dfrister/Practicum2014/Presentation/Images/display_bottom.jpg

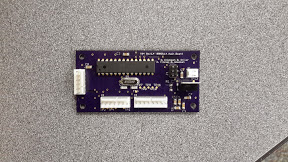
Presentation/Images/display_bottom.jpg
