dfrister/Practicum2014/Presentation/Images/display_top.jpg

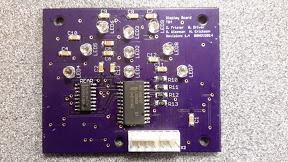
Presentation/Images/display_top.jpg
