dfrister/Practicum2014/Code/README.txt

FinalCode:
This version of the code is completely functional and uploaded to all our boards.
