dfrister/Practicum2014/Enclosures/Sensor Enclosure.pdf

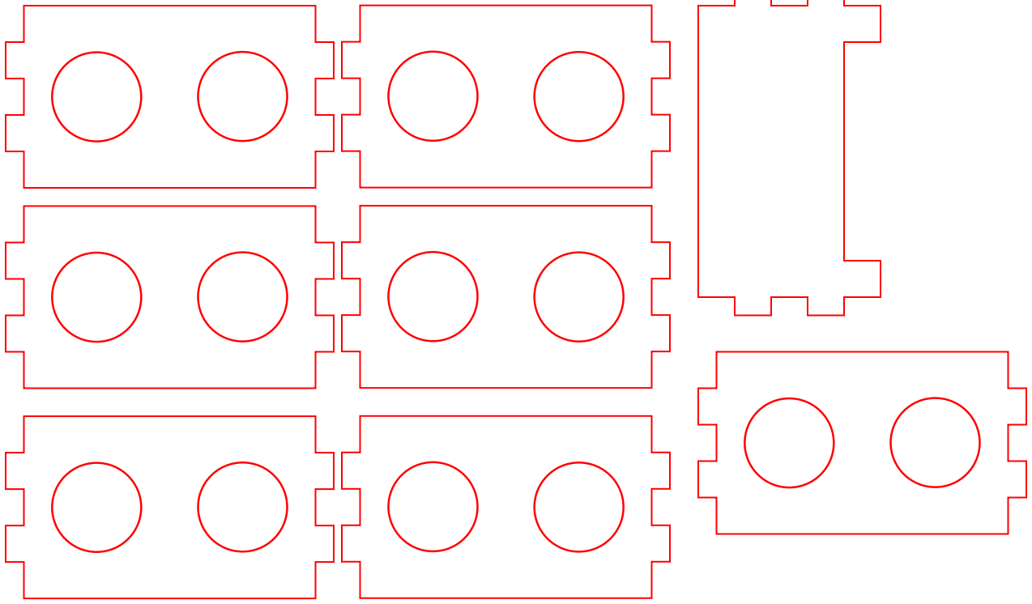
[picture p14: figure]
