dfrister/Practicum2014/UML/InteractiveView.pdf

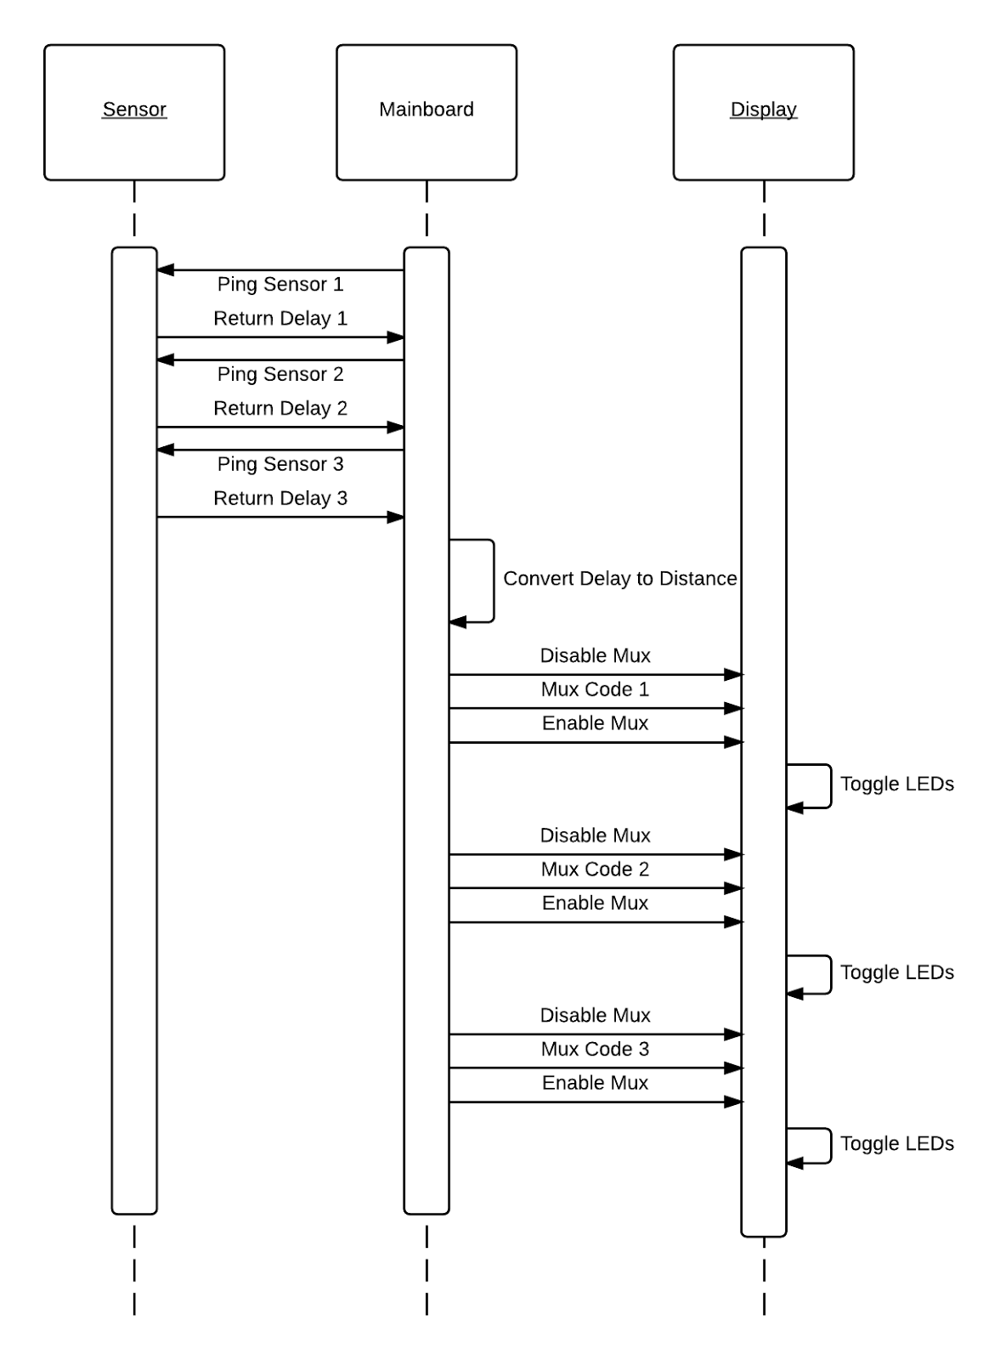
[picture p15: figure]

Interaction View
