dfrister/Practicum2014/UML/MainBoardStateDiagram.pdf

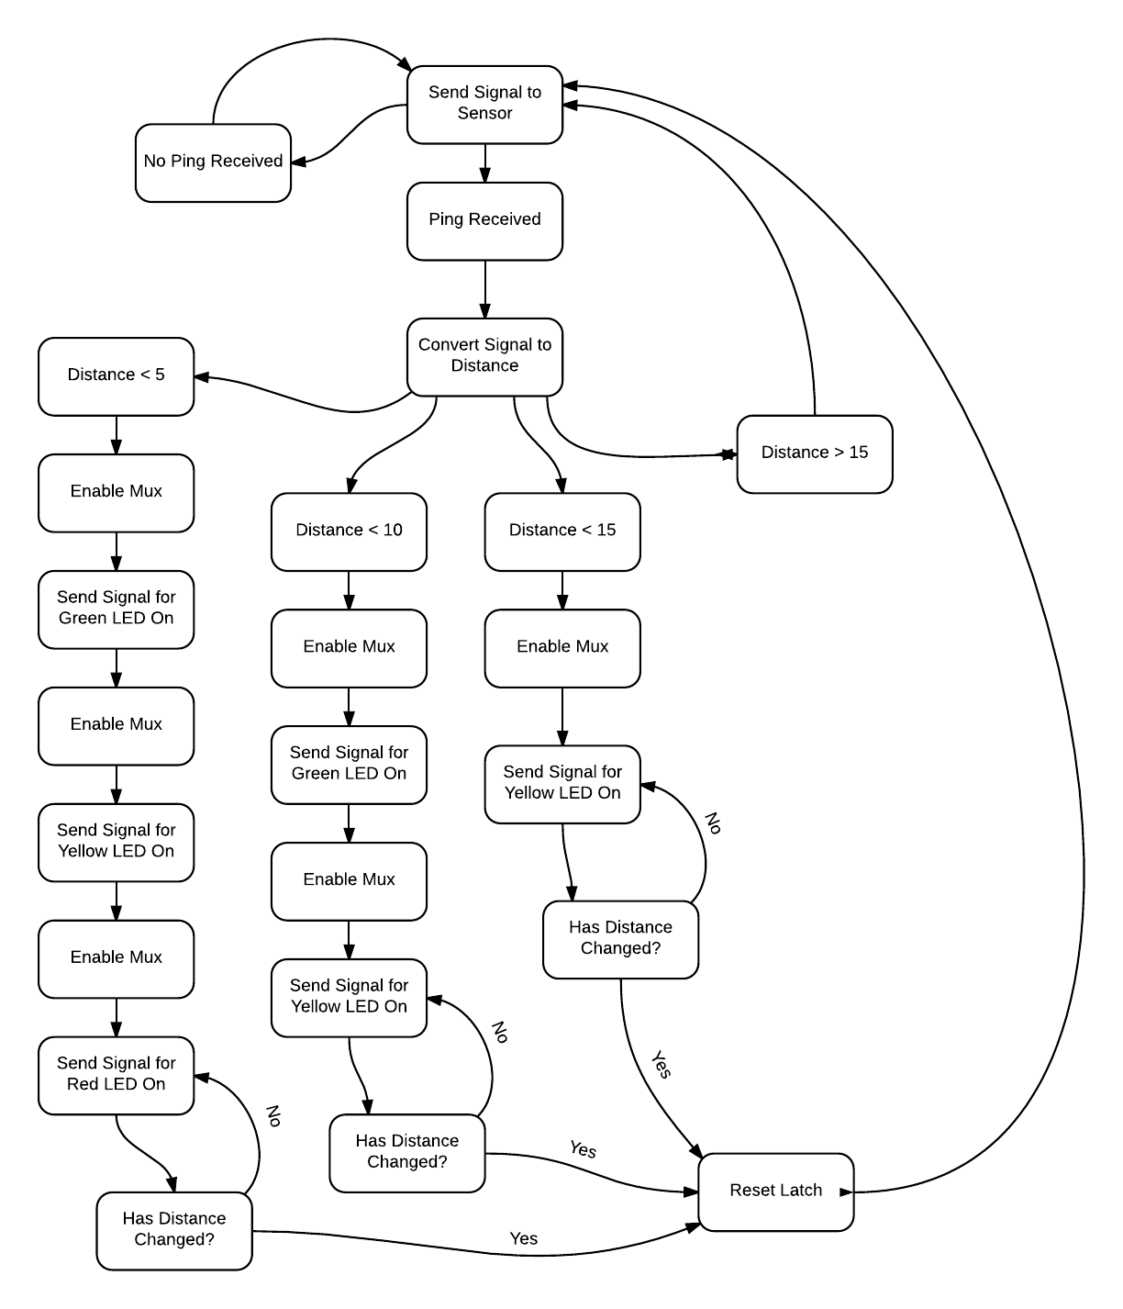
[picture p16: figure]
