dfrister/Practicum2014/Meeting Notes/20OCT2014Notes.pdf

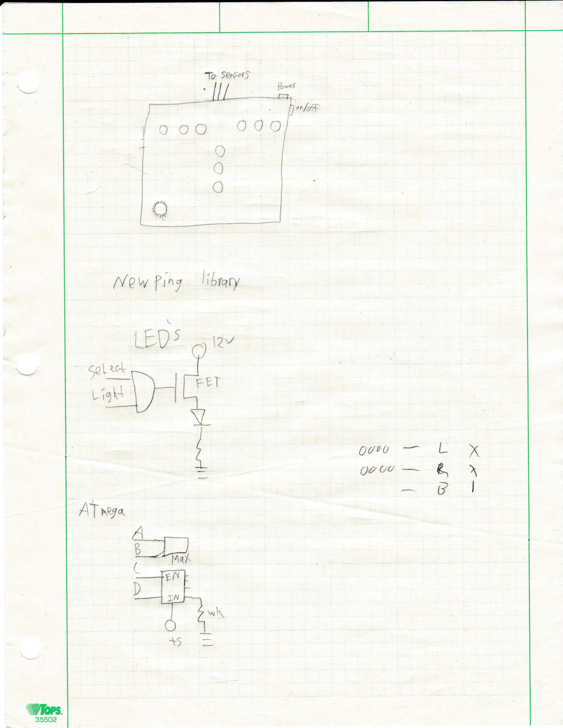
[picture p17: page 1]

- | a... | !

?rt0 .-

cl6 80
-T

### ,.LXq\

#l

{
:-

## I r&d 6rT

## :!.- i i ' I'

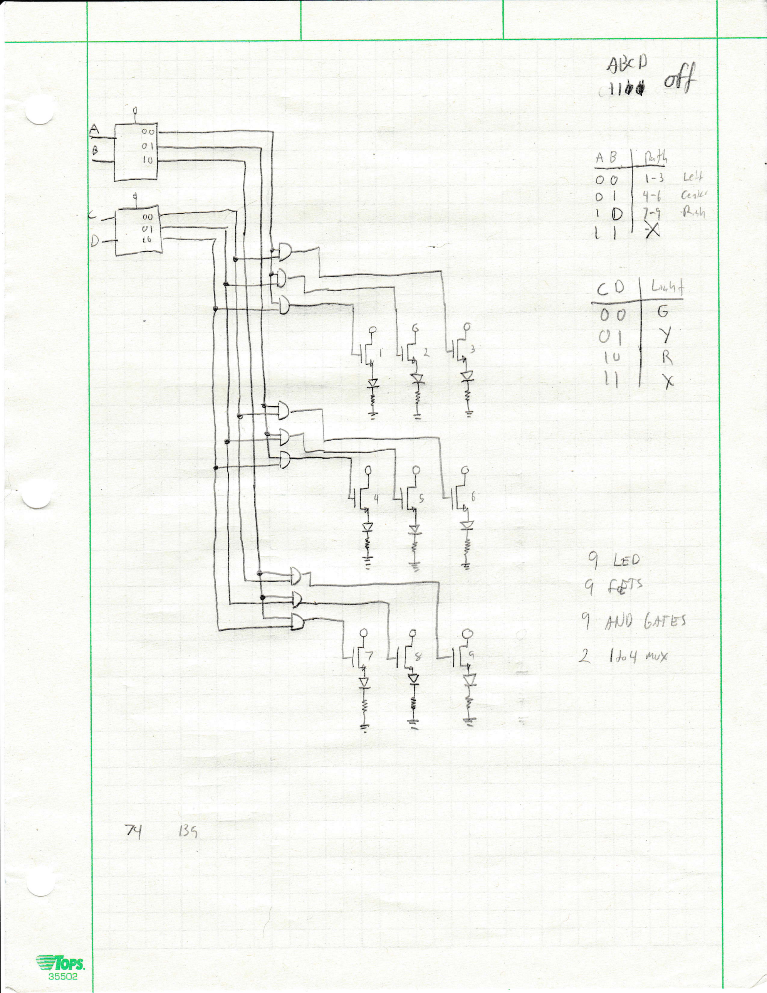
[picture p18: page 2]

a t- i

## -lr-I

# ill

t

lY

# ii ll f

x

4B{ D rr

ii
--,i*"*- I

ijU ii
.I ...ii--l I {i) i

1 Leo

## q F$t

### 1 *r;i 6*re'l

2 lS.rl xuq rl

ai I I q

lsL' vTJt

"_

Yi

\i
t.'4I
\:7

.:

7rl t3\

=roHs. 35502
