dfrister/Practicum2014/Project Ideas and Proposal/Decision Matrix.xlsx

Criteria: |  |  | Projects:
Complexity | A |  | IR Power | 1
Match to Skills | B |  | Shift Light | 2
Feasibility | C |  | Kid Leash | 3
Personal Interest | D |  | Prox Sensor | 4
Usefulness | E
Weighting Chart
 | A | B | C | D | E | Geometric Mean | Normalized Weights
A | 1.00 | 3.00 | 1.00 | 0.33 | 5 | 1.37 | 0.24
B | 0.33 | 1 | 0.33 | 0.33 | 3 | 0.64 | 0.11
C | 1 | 3 | 1 | .33 | 3 | 1.2 | 0.21
D | 3 | 3 | 3 | 1 | 7 | 2.2 | 0.38
E | .2 | .33 | .33 | .14 | 1 | 0.31 | 0.05
Comparison: Complexity | 1 | 2 | 3 | 4 | Geometric Mean | Normalized Weights |  | Scores
1 | 1 | 3 | 5 | 3 | 2.942830956 | 0.5209547068 |  | Selection Criteria | Weights | Alternatives
2 | 0.33 | 1 | 2 | 1 | 1.071873374 | 0.1897484046 |  |  |  | 1 | 2 | 3 | 4
3 | 0.2 | 0.5 | 1 | 0.5 | 0.5623413252 | 0.09954848393 |  | A (Complexity) | 0.24 | 0.5209547068 | 0.1897484046 | 0.09954848393 | 0.1897484046
4 | 0.33 | 1 | 2 | 1 | 1.071873374 | 0.1897484046 |  | B (Skills) | 0.11 | 0.3520015706 | 0.1760007853 | 0.1760007853 | 0.2959968589
 |  |  |  |  |  |  |  | C (Feasibility) | 0.21 | 0.3539527705 | 0.1019209567 | 0.1901735022 | 0.3539527705
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
