dfrister/Practicum2014/Presentation/Images/Mainboard.jpg

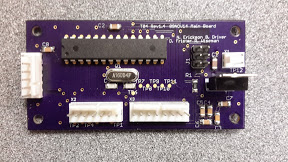
Presentation/Images/Mainboard.jpg
