dfrister/Practicum2014/Wiki Images/Concept.jpg

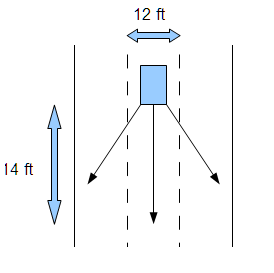
Wiki Images/Concept.jpg
