dfrister/Practicum2014/Components/Components and Pricing Sheet.xlsx

Manufacturer | Part # | Component | Supplier | Price | Qty/Person | Total Qty | Total Price |  | Model |  | Prototype Order 10/26
Lite-On | LTL1CHKGKNN | Green LED | Mouser | $0.11 | 3 | 12 | $1.28 | 3mm | Final | Final Build | Manufacturer | Part # | Component | Supplier | Price | Qty | Total
Lite-On | LTL1CHKEKNN | Red LED | Mouser | $0.09 | 3 | 12 | $1.08 | 3mm | Final | Prototype | Lite-On | LTL1CHKGKNN | Green LED | Mouser | $0.11 | 12 | $1.28
Lite-On | LTL1CHKSKNN | Yellow LED | Mouser | $0.10 | 3 | 12 | $1.22 | 3mm | Final | Ordered | Lite-On | LTL1CHKEKNN | Red LED | Mouser | $0.09 | 12 | $1.08
Fairchild | 2n7002DW | Dual N-channel FET | Mouser | $0.28 | 5 | 20 | $5.52 | smt | Final | Substituted | Lite-On | LTL1CHKSKNN | Yellow LED | Mouser | $0.10 | 12 | $1.22
Fairchild | 2n7000 | N-Channel FET | Mouser | $0.24 | 10 | 10 | $2.40 | Thru-Hole | Prototype |  | Fairchild | 2n7000 | N-Channel FET | Mouser | $0.24 | 10 | $2.40
ON-Semiconductor | MC14514BDWR2G | 4-16 demux | Mouser | $1.61 | 1 | 4 | $6.44 | smt | n/a |  | NXP Semiconductor | HEF4067BPN | 4-16 demux | Mouser | $5.43 | 1 | $5.43
ON-Semiconductor | CD4043BE | Quad SR latch | Mouser | $0.60 | 3 | 4 | $2.40 | Thru-Hole | Prototype |  | ON-Semiconductor | CD4043BE | Quad SR latch | Mouser | $0.60 | 4 | $2.40
ON-Semiconductor | CD4043BDWR | Quad SR latch | Mouser | $0.67 | 3 | 12 | $8.04 | SMT | final
NXP Semiconductor | HEF4067BPN | 4-16 demux | Mouser | $5.43 | 1 | 1 | $5.43 | Thru-Hole | Prototype
NXP Semiconductor | HEF4067BT | 4-16 demux | Mouser | $2.38 | 1 | 4 | $9.52 | SMT | final |  |  |  |  |  |  | Shipping | 6.99
 |  |  |  |  |  | 0 | $0.00
 |  |  |  |  |  | 0 | $0.00
 |  |  |  |  |  | 0 | $0.00
 |  |  |  |  |  | 0 | $0.00 |  |  |  |  |  |  |  |  |  | $20.81
 |  |  |  |  |  | 0 | $0.00
 |  |  |  |  |  | 0 | $0.00
