dfrister/Practicum2014/Test Plan/Test_Case_4.5.1_integration.xlsx

Test Writer: Daniel Frister
Test Case Name: |  | Main Board to Display Test #1 |  |  | Test ID: | MPS-Integration-01
Description: |  | Checks that binary inputs to the display board produce the correct corresponding outputs on the demultiplexer. |  |  | Type: | Black Box
Tester Information:
Name of Tester: |  |  |  |  | Date:
Harware Ver: |  | Main Board V1.0, Display V1.0 |  |  | Time:
Setup: |  | Display board should have 5V and seven pin cable to main board attached. Main board should be powered, have seven pin cable to display board connected, and be loaded with a program to output as a four bit digital up counter with output enable at clock rate 0.5 Hz. Oscilloscope should be connected at channels A0-A3 on main board molex connector.
Step | Action | Expected Result | Pass | Fail | Comments
1 | Observe binary 0 | Right Display Green LED lights
2 | Observe binary 1 | Right Display Yellow LED lights
3 | Observe binary 2 | Right Display Red LED lights
4 | Observe binary 3 | All Right Display LEDs turn off
5 | Observe binary 4 | Rear Display Green LED lights
6 | Observe binary 5 | Rear Display Yellow LED lights
7 | Observe binary 6 | Rear Display Red LED lights
8 | Observe binary 7 | All Rear Display LEDs turn off
9 | Observe binary 8 | Left Display Green LED lights
10 | Observe binary 9 | Left Display Yellow LED lights
11 | Observe binary 10 | Left Display Red LED lights
12 | Observe binary 11 | All Left Display LEDs turn off
13 | Observe binary 12 | No display changes
14 | Observe binary 13 | No display changes
15 | Observe binary 14 | No display changes
16 | Observe binary 15 | No display changes
Overall test result
