dfrister/Practicum2014/Test Plan/Test_Case_4.5.3_system.xlsx

Test Writer: Branden Driver
Test Case Name: |  | Entire System Test #1 |  |  | Test ID: | MPS-System-01
Description: |  | Checks that all connections are functioning properly and that the code loaded onto the microcontroller is set for the correct distances. |  |  | Type: | Black Box
Tester Information:
Name of Tester: |  |  |  |  | Date:
Harware Ver: |  | Display V1.0, Main Board V1.5, Sensor V1.0 |  |  | Time:
Setup: |  | Both Sensor Board and Display Board will be wire-connected to the Main Board. Main Board will be connected to power supply of at least 6V and at most 12V. Set Sensor Board on edge of table with Left Sensor facing straight out. Using tape measure and masking tape, mark off distances of 5, 10, and 15 feet. Have a flat, solid, light-weight surface (such as a textbook) to place in front of sensor at different distances.
Step | Action | Expected Result | Pass | Fail | Comments
1 | Place suface at distance of 15' | Left Green LED lights up
2 | Place suface at distance of 10' | Left Green and Yellow LEDs light up
3 | Place suface at distance of 5' | Left Green, Yellow, and Red LEDs light up
4 | Rotate Sensor Board so Rear Sensor faces out | Rear Sensor ready to be tested
5 | Place suface at distance of 15' | Rear Green LED lights up
6 | Place suface at distance of 10' | Rear Green and Yellow LEDS light up
7 | Place suface at distance of 5' | Rear Green, Yellow, and Red LEDs light up
8 | Rotate Sensor Board so Right Sensor faces out | Right Sensor ready to be tested
9 | Place suface at distance of 15' | Right Green LED lights up
10 | Place suface at distance of 10' | Right Green and Yellow LEDs light up
11 | Place suface at distance of 5' | Right Green, Yellow, and Red LEDs light up
Overall test result
