dfrister/Practicum2014/Test Plan/TestCaseMainboardHelloWorld.xls

Test Writer: Noah L. Engineer
Test Case Name: |  | Motorcycle Proximity Sensor Mainboard Path Test #1 |  |  |  | Test ID #: | MPS-Main Path-01
Description: |  | Upload “Hello World” to microcontroller |  |  |  | Type: | Black Box
Tester Information
Name of Tester: |  |  |  |  |  | Date:
Hardware Ver: |  | Mainboard Rev 1.5 |  |  |  | Time:
Setup: |  | The mainboard should be completely assembled and should be connected to the 5V power supply. The input voltage to the power supply should be anywhere from 6V to 12V. The USB to serial programming cable should be connected to the 6 pin serial programming header on the mainboard. A standard 5mm LED should be connected to one of the display board header pins and a 330 Ohm resistor.
Step | Action | Expected Result | Pass | Fail | N/A | Comments
1 | Turn on input voltage | Mainboard should be powered
2 | Write program in Arduino IDE | A source code file that compiles without errors with the purpose of blinking an LED
3 | Upload program to mainboard | The program should
4 | Wait | The LED should blink
Overall Test Result:
