dfrister/Practicum2014/Presentation/Images/T04_Display.sch.pdf

1 | 2 | 3 | 4 | 5 | 6 | 7 | 8 | 9

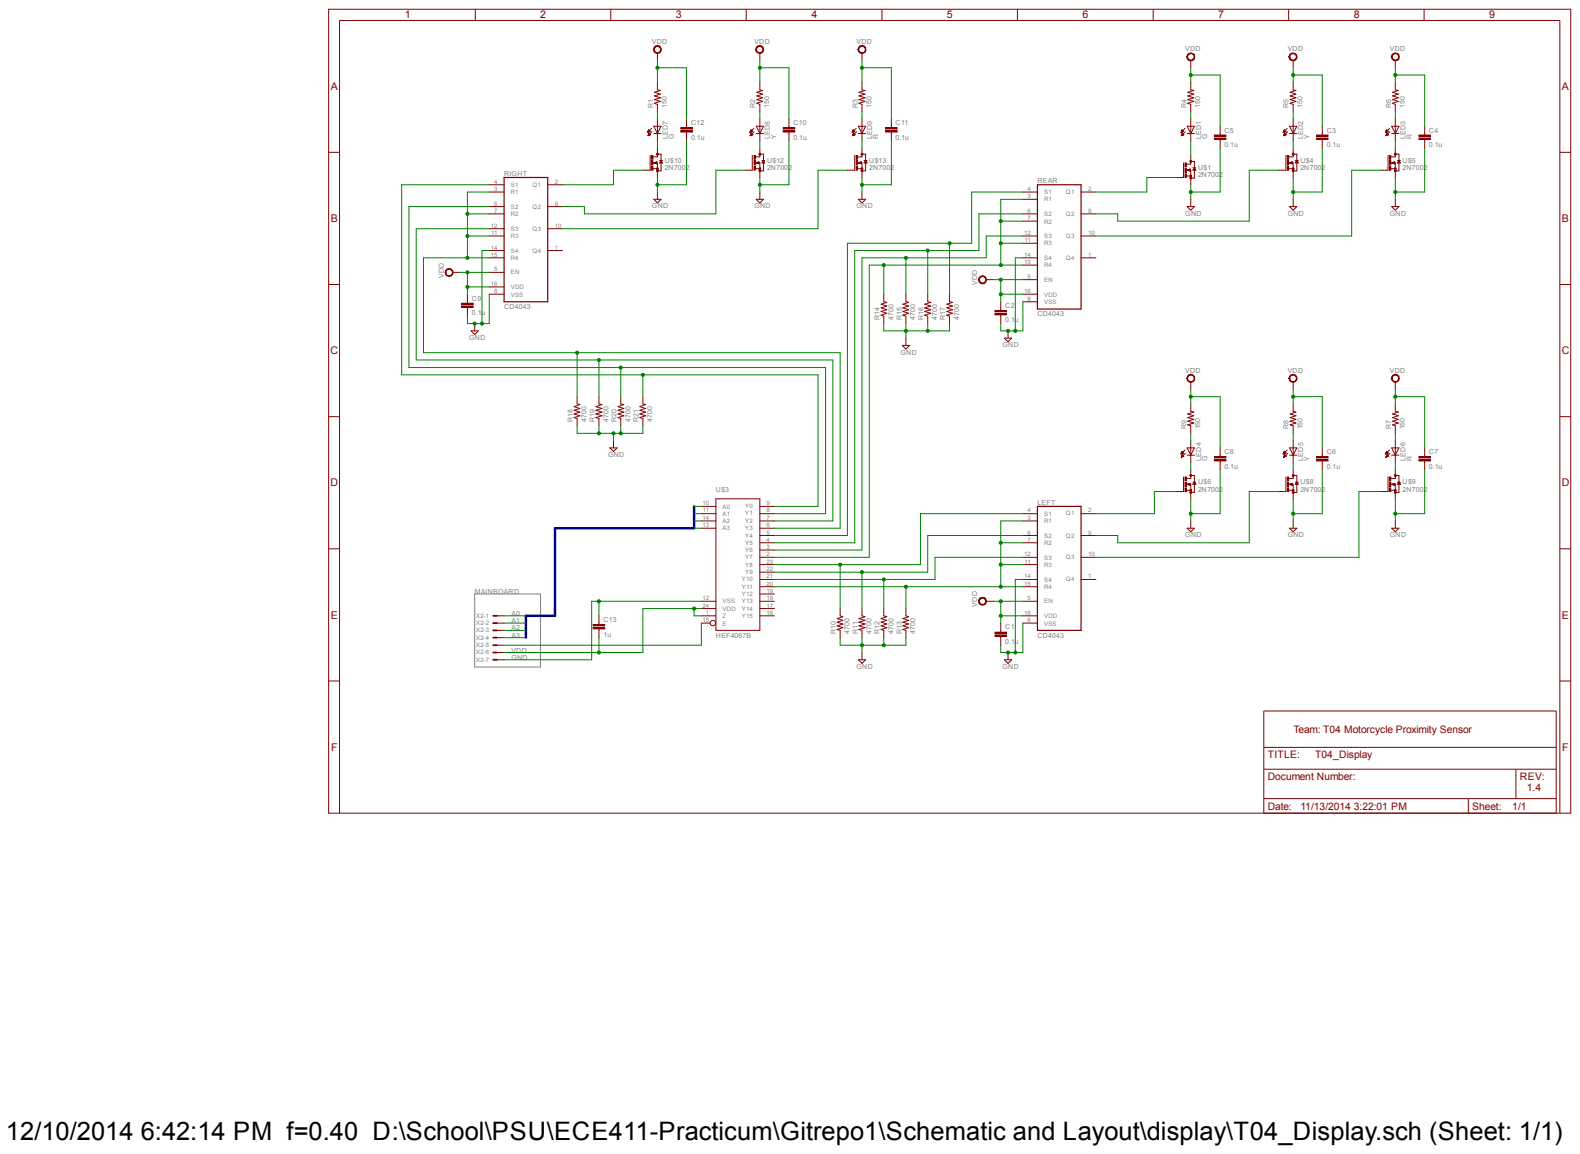
[picture p21: page 1]

R3 11 S3 12
S4 14 | | R3 11 S3 12

Team: T04 Motorcycle Proximity Sensor

Document Number: | REV: 1.4

Date: 11/13/2014 3:22:01 PM | Sheet: 1/1

12/10/2014 6:42:14 PM f=0.40 D:\School\PSU\ECE411-Practicum\Gitrepo1\Schematic and Layout\display\T04_Display.sch (Sheet: 1/1)
