dfrister/Practicum2014/Presentation/Images/T04_Main_Board.sch.pdf

A

A

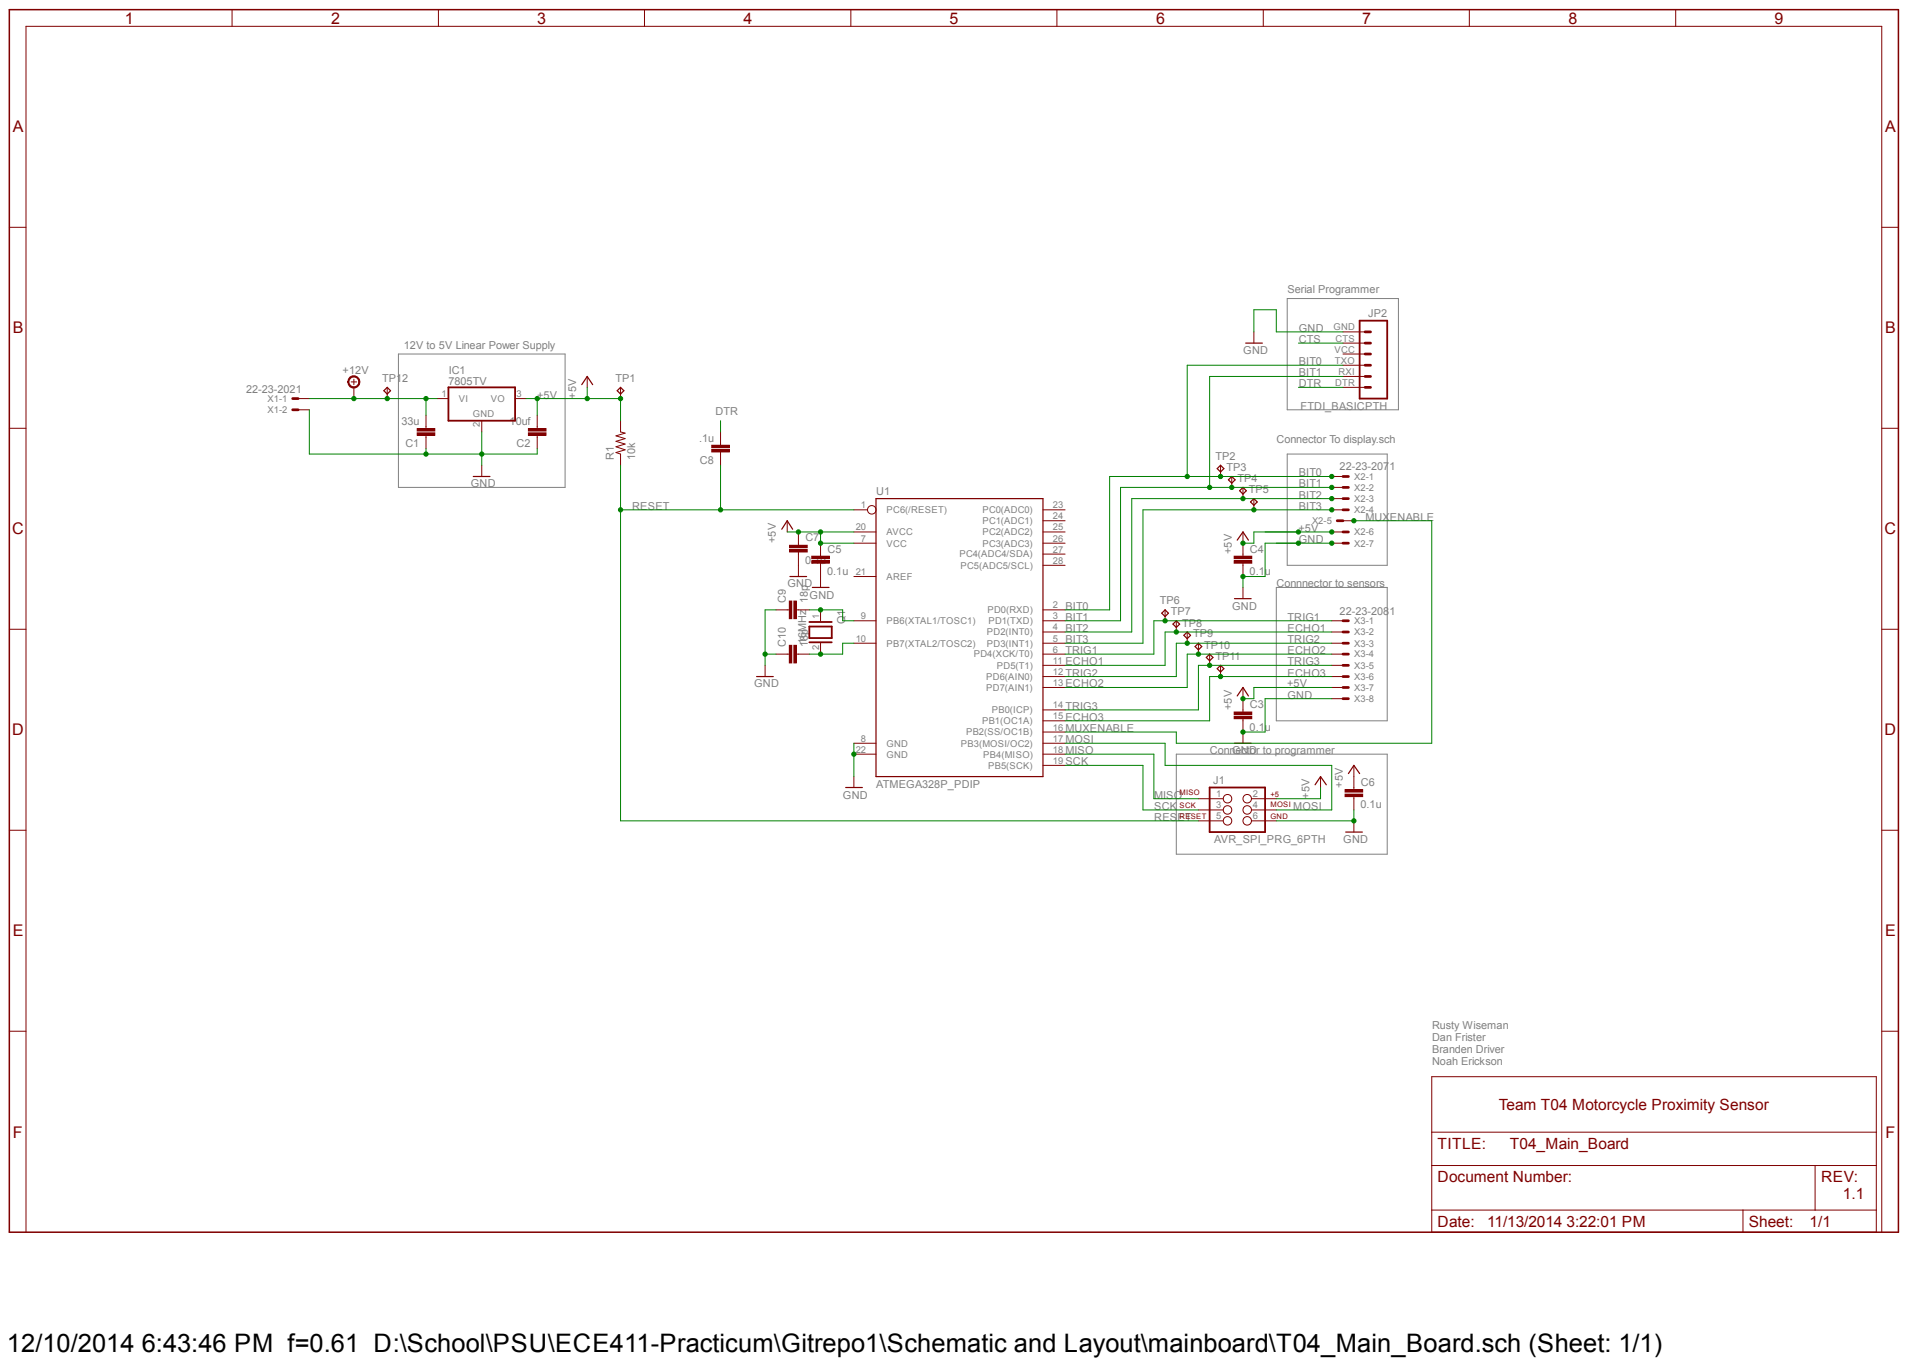
[picture p22: page 1]

12V to 5V Linear Power Supply

BIT1 RXI

FTDI_BASICPTH

Connector To display.sch

Team T04 Motorcycle Proximity Sensor

Document Number: | REV: 1.1

Date: 11/13/2014 3:22:01 PM | Sheet: 1/1

12/10/2014 6:43:46 PM f=0.61 D:\School\PSU\ECE411-Practicum\Gitrepo1\Schematic and Layout\mainboard\T04_Main_Board.sch (Sheet: 1/1)
