dfrister/Practicum2014/Enclosures/Display Enclosure Rev1.0/Bottom_Piece.pdf

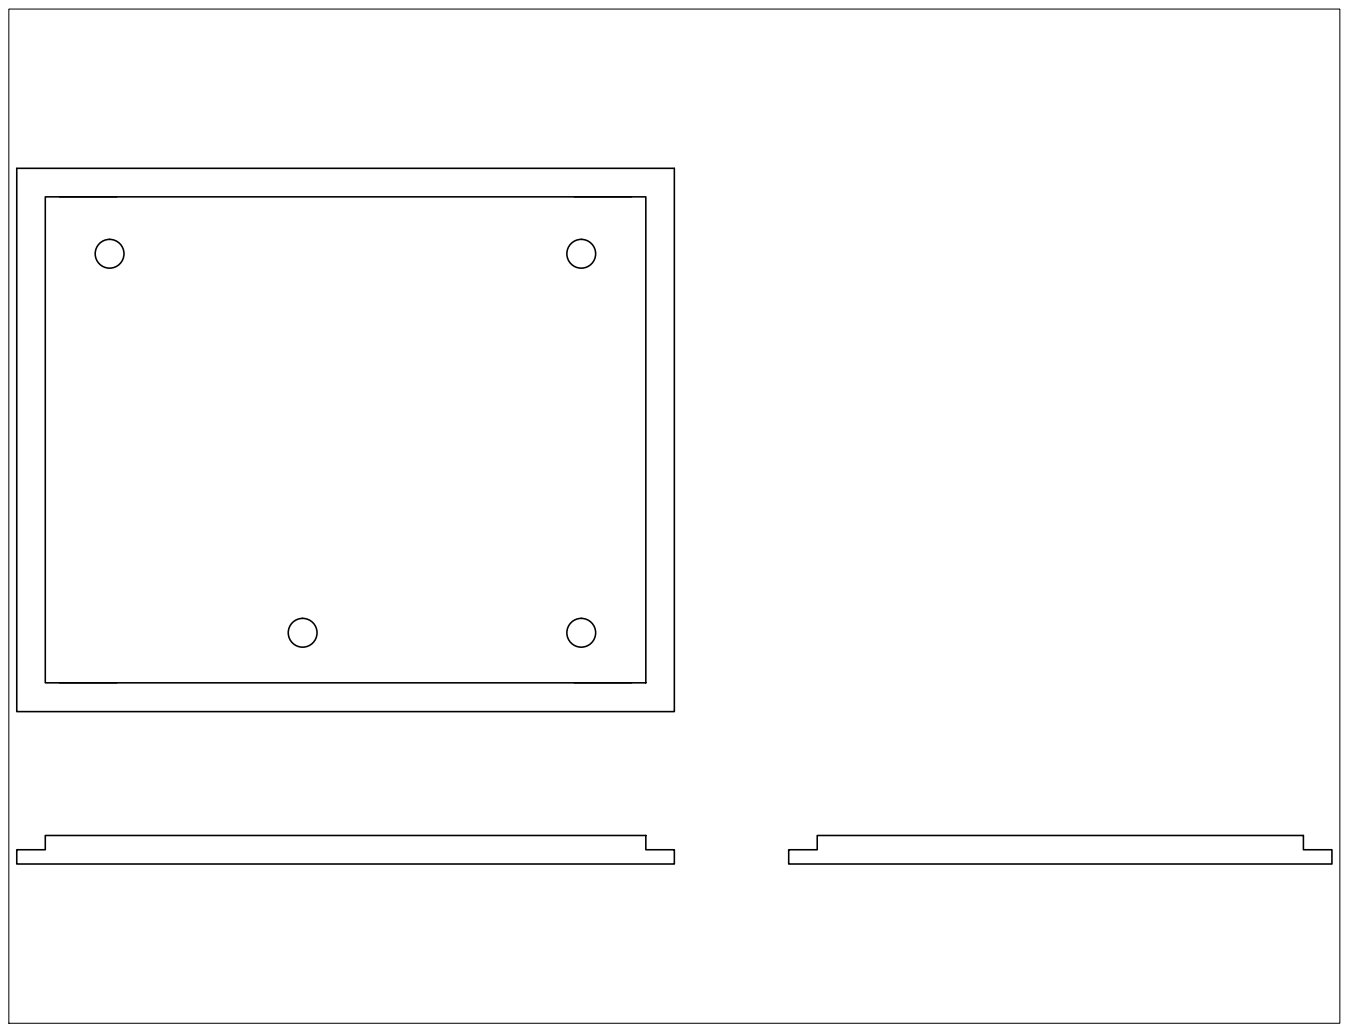
[picture p23: page 1]
