dfrister/Practicum2014/Enclosures/Display Enclosure Rev1.0/Enclosure3_Pieces.pdf

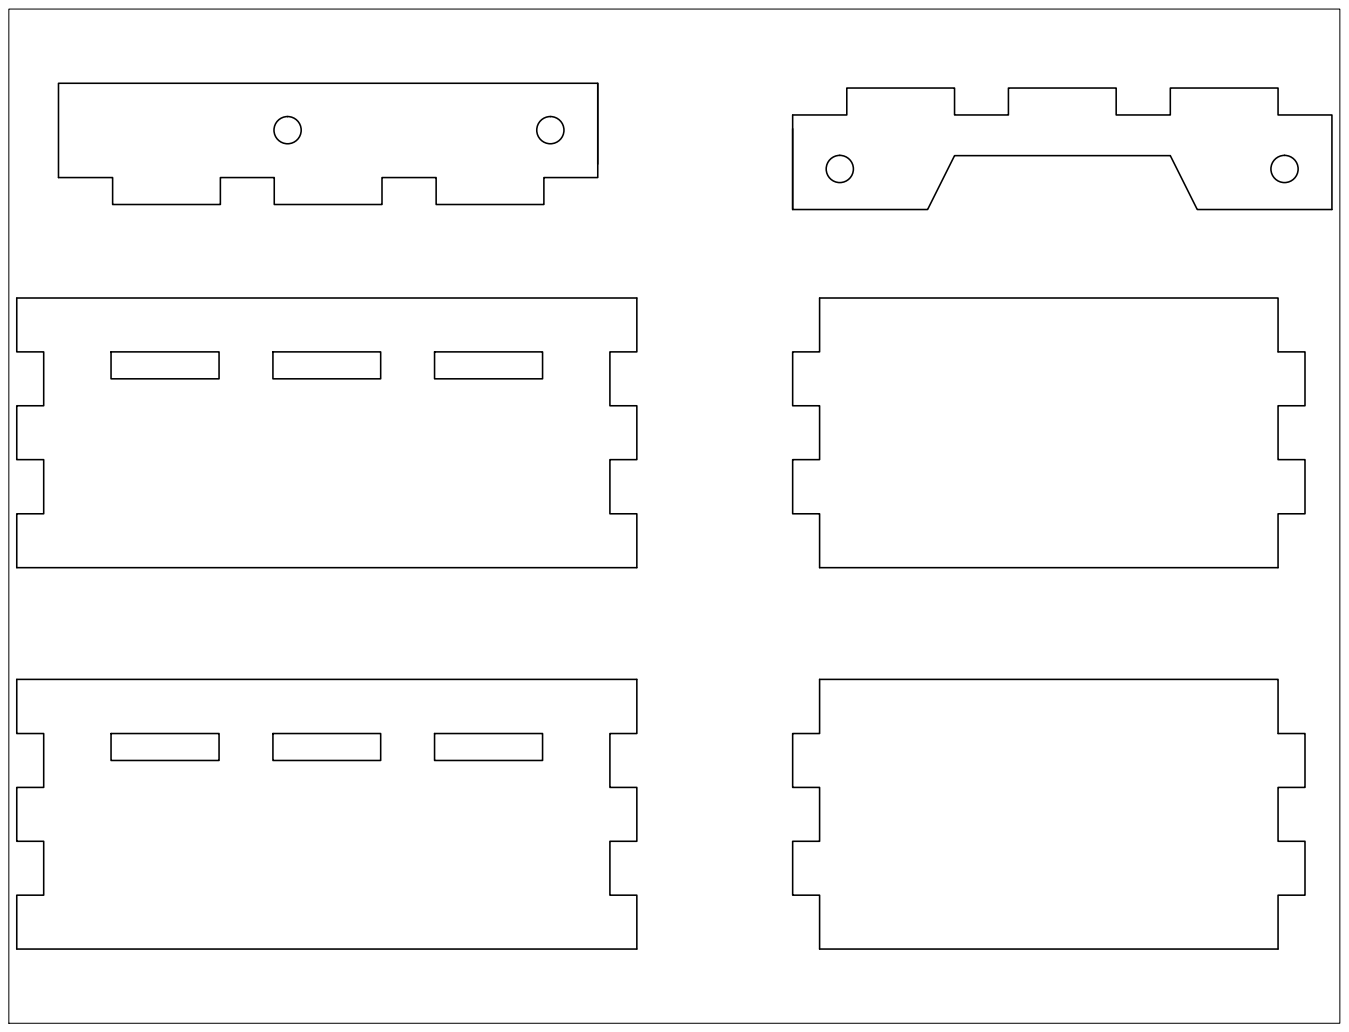
[picture p24: page 1]
