dfrister/Practicum2014/Enclosures/Display Enclosure Rev1.0/Top_Piece.pdf

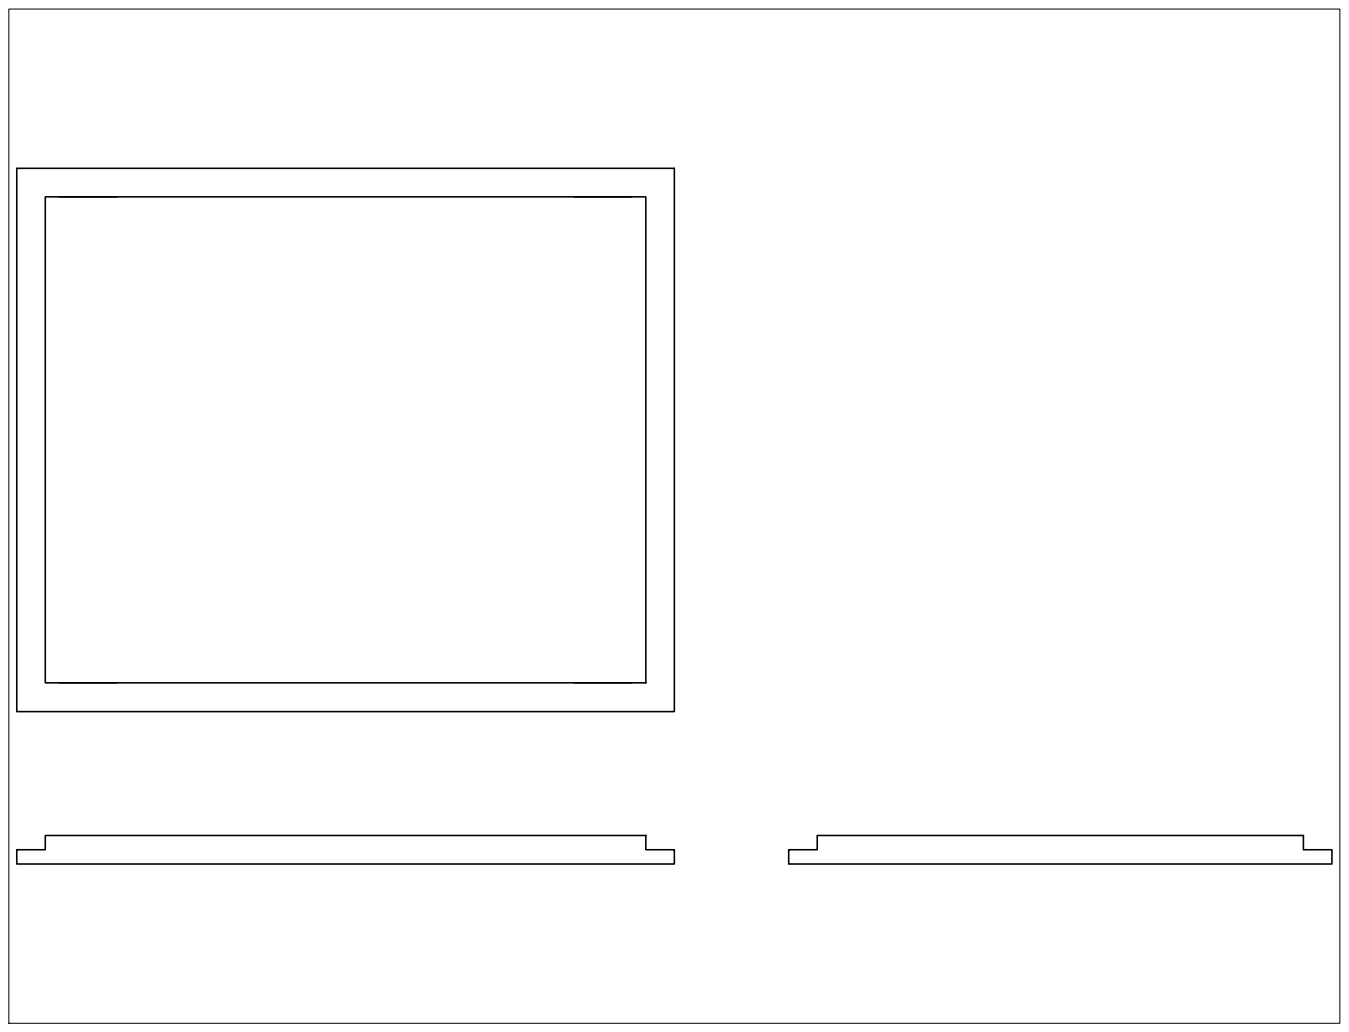
[picture p25: page 1]
