dfrister/Practicum2014/(list of files, drawings)

Other design files:
Code/PrototypeCode/prototype_rev1/UnoBuild.fzz
