dfrister/Practicum2014/Schematic and Layout/Display2/Brandens old Board/T04_Display.brd

## EAGLE design Schematic and Layout/Display2/Brandens old Board/T04_Display.brd (2014-11-09, an earlier design)

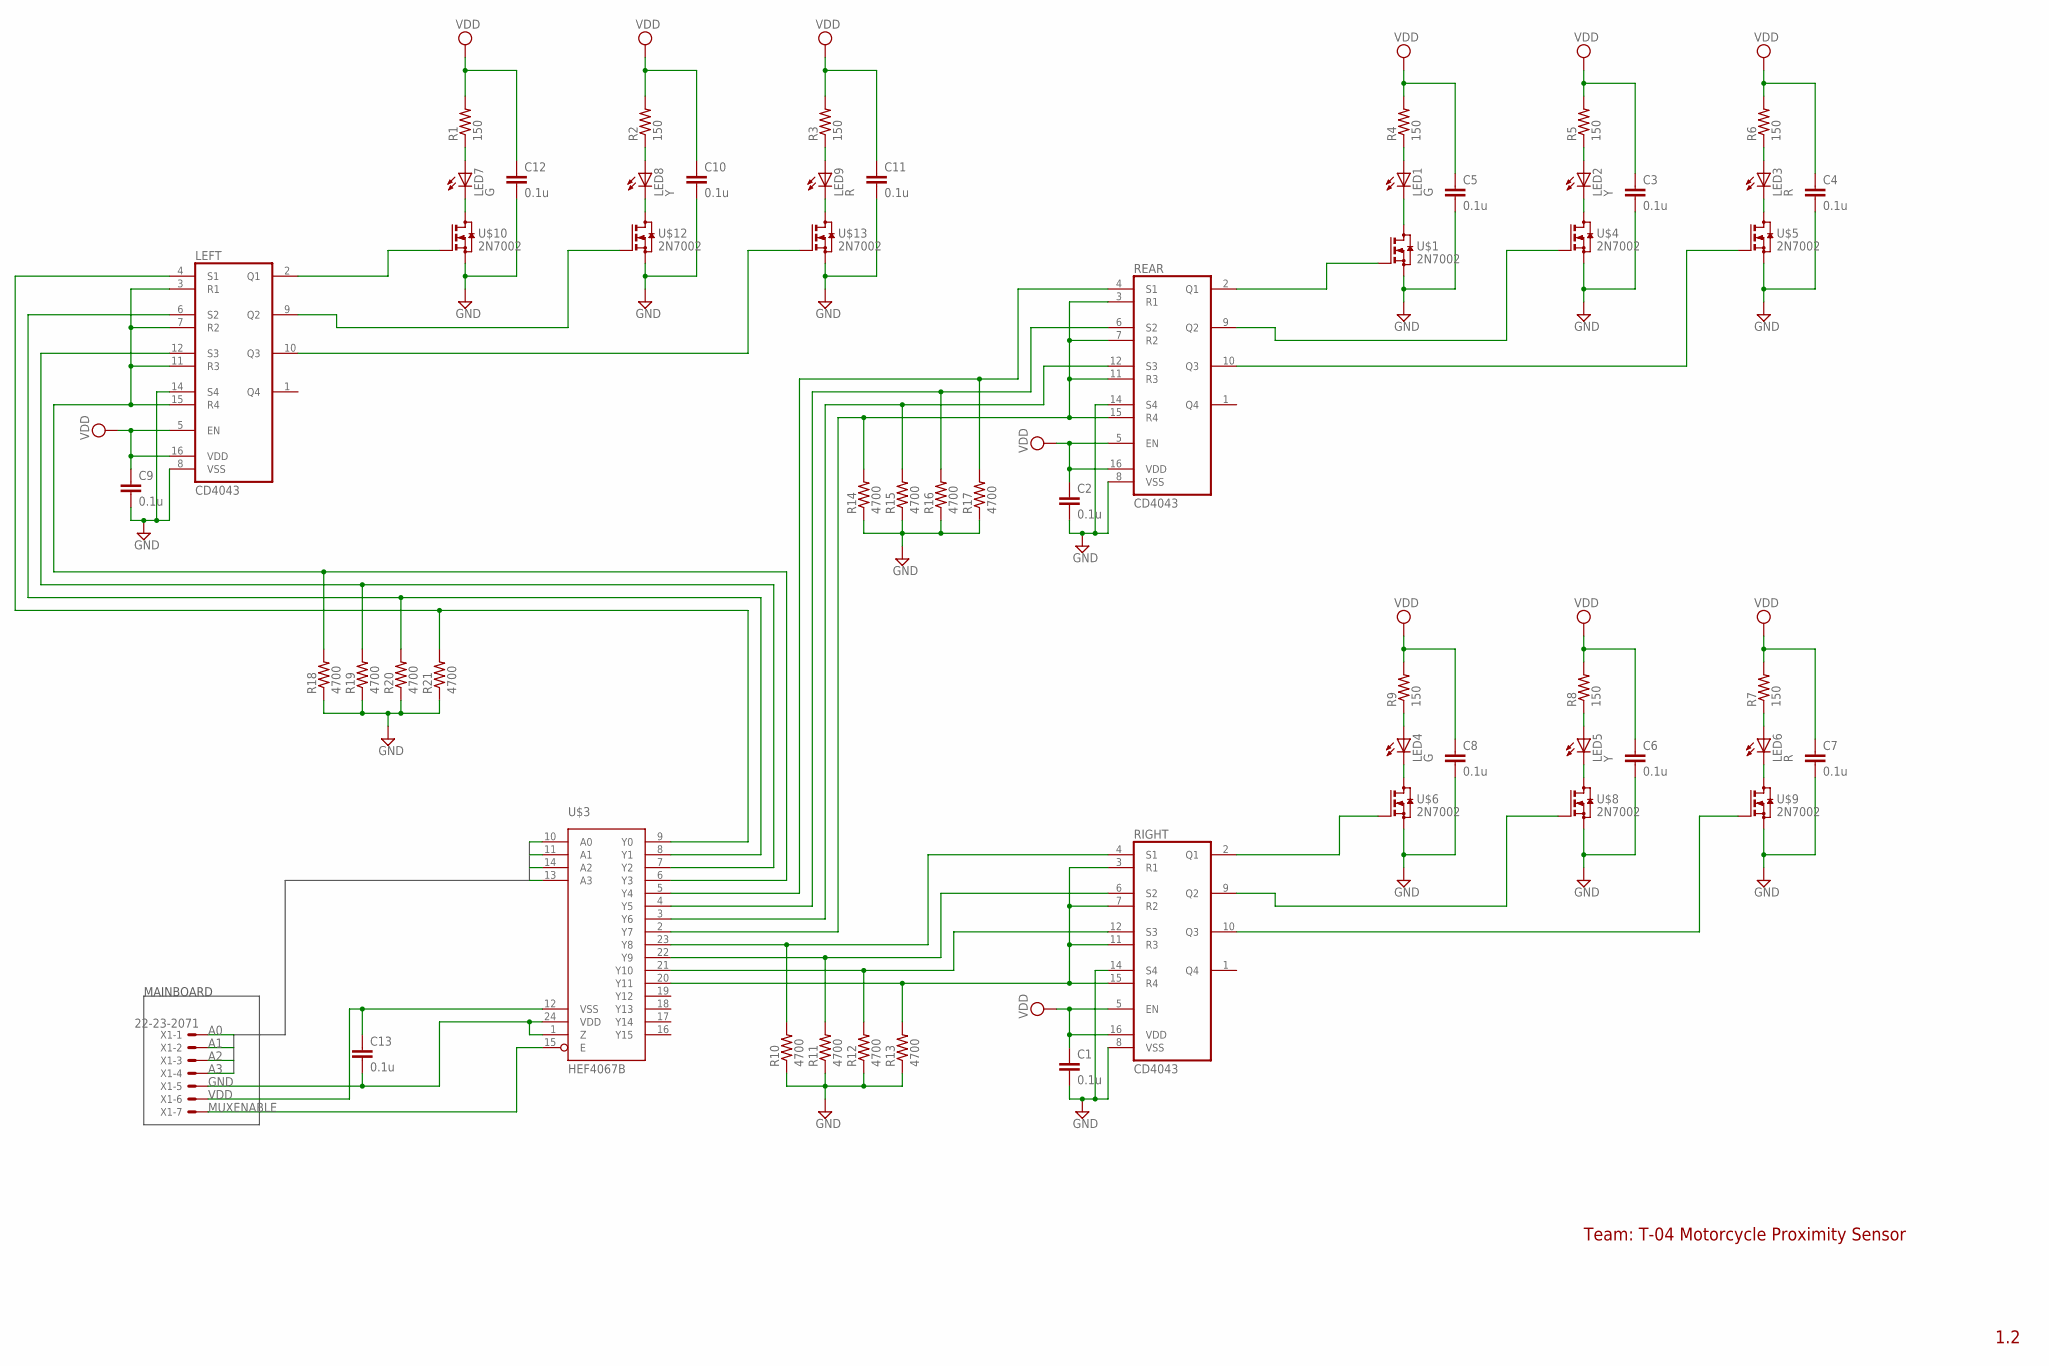
[picture p26: schematic T04_Display.sch]

Parts:
C1, C2, C3, C4, C5, C6, C7, C8, C9, C10, C11, C12, C13: 0.1u; C1206
LED1, LED4, LED7: G; LED3MM
LED2, LED5, LED8: Y; LED3MM
LED3, LED6, LED9: R; LED3MM
LEFT: CD4043; SOIC16N
R1, R2, R3, R4, R5, R6, R7, R8, R9: 150; R1206
R10, R11, R12, R13, R14, R15, R16, R17, R18, R19, R20, R21: 4700; R1206
REAR: CD4043; SOIC16N
RIGHT: CD4043; SOIC16N
U$1, U$4, U$5, U$6, U$8, U$9, U$10, U$12, U$13: 2N7002; SOT23
U$3: HEF4067B; SO24W
X1: 22-23-2071

Connections:
A0: U$3.10 (A0), X1.1
A1: U$3.11 (A1), X1.2
A2: U$3.14 (A2), X1.3
A3: U$3.13 (A3), X1.4
BG: LEFT.2 (Q1), U$10.1 (G)
BR: LEFT.10 (Q3), U$13.1 (G)
BRES: LEFT.3 (R1), LEFT.7 (R2), LEFT.11 (R3), LEFT.15 (R4), R18.2, U$3.6 (Y3)
BS1: LEFT.4 (S1), R21.2, U$3.9 (Y0)
BS2: LEFT.6 (S2), R20.2, U$3.8 (Y1)
BS3: LEFT.12 (S3), R19.2, U$3.7 (Y2)
BY: LEFT.9 (Q2), U$12.1 (G)
GND: C1.2, C2.2, C3.2, C4.2, C5.2, C6.2, C7.2, C8.2, C9.2, C10.2, C11.2, C12.2, C13.1, LEFT.8 (VSS), LEFT.14 (S4), R10.1, R11.1, R12.1, R13.1, R14.1, R15.1, R16.1, R17.1, R18.1, R19.1, R20.1, R21.1, REAR.8 (VSS), REAR.14 (S4), RIGHT.8 (VSS), RIGHT.14 (S4), U$1.2 (S), U$3.12 (VSS), U$4.2 (S), U$5.2 (S), U$6.2 (S), U$8.2 (S), U$9.2 (S), U$10.2 (S), U$12.2 (S), U$13.2 (S), X1.6
LG: REAR.2 (Q1), U$1.1 (G)
LR: REAR.10 (Q3), U$5.1 (G)
LRES: R14.2, REAR.3 (R1), REAR.7 (R2), REAR.11 (R3), REAR.15 (R4), U$3.2 (Y7)
LS1: R17.2, REAR.4 (S1), U$3.5 (Y4)
LS2: R16.2, REAR.6 (S2), U$3.4 (Y5)
LS3: R15.2, REAR.12 (S3), U$3.3 (Y6)
LY: REAR.9 (Q2), U$4.1 (G)
MUXENABLE: U$3.15 (E), X1.7
unnamed: LED3.K (C), U$5.3 (D)
unnamed: LED2.K (C), U$4.3 (D)
unnamed: LED1.K (C), U$1.3 (D)
unnamed: LED1.A, R4.1
unnamed: LED3.A, R6.1
unnamed: LED4.A, R9.1
unnamed: LED5.A, R8.1
unnamed: LED2.A, R5.1
unnamed: LED6.A, R7.1
unnamed: LED7.K (C), U$10.3 (D)
unnamed: LED7.A, R1.1
unnamed: LED8.K (C), U$12.3 (D)
unnamed: LED8.A, R2.1
unnamed: LED9.K (C), U$13.3 (D)
unnamed: LED9.A, R3.1
unnamed: LED6.K (C), U$9.3 (D)
unnamed: LED4.K (C), U$6.3 (D)
unnamed: LED5.K (C), U$8.3 (D)
RG: RIGHT.2 (Q1), U$6.1 (G)
RR: RIGHT.10 (Q3), U$9.1 (G)
RRES: R13.2, RIGHT.3 (R1), RIGHT.7 (R2), RIGHT.11 (R3), RIGHT.15 (R4), U$3.20 (Y11)
RS1: R10.2, RIGHT.4 (S1), U$3.23 (Y8)
RS2: R11.2, RIGHT.6 (S2), U$3.22 (Y9)
RS3: R12.2, RIGHT.12 (S3), U$3.21 (Y10)
RY: RIGHT.9 (Q2), U$8.1 (G)
VDD: C1.1, C2.1, C3.1, C4.1, C5.1, C6.1, C7.1, C8.1, C9.1, C10.1, C11.1, C12.1, C13.2, LEFT.5 (EN), LEFT.16 (VDD), R1.2, R2.2, R3.2, R4.2, R5.2, R6.2, R7.2, R8.2, R9.2, REAR.5 (EN), REAR.16 (VDD), RIGHT.5 (EN), RIGHT.16 (VDD), U$3.1 (Z), U$3.24 (VDD), X1.5

Notes on the sheet:
MAINBOARD
Team: T-04 Motorcycle Proximity Sensor
1.2

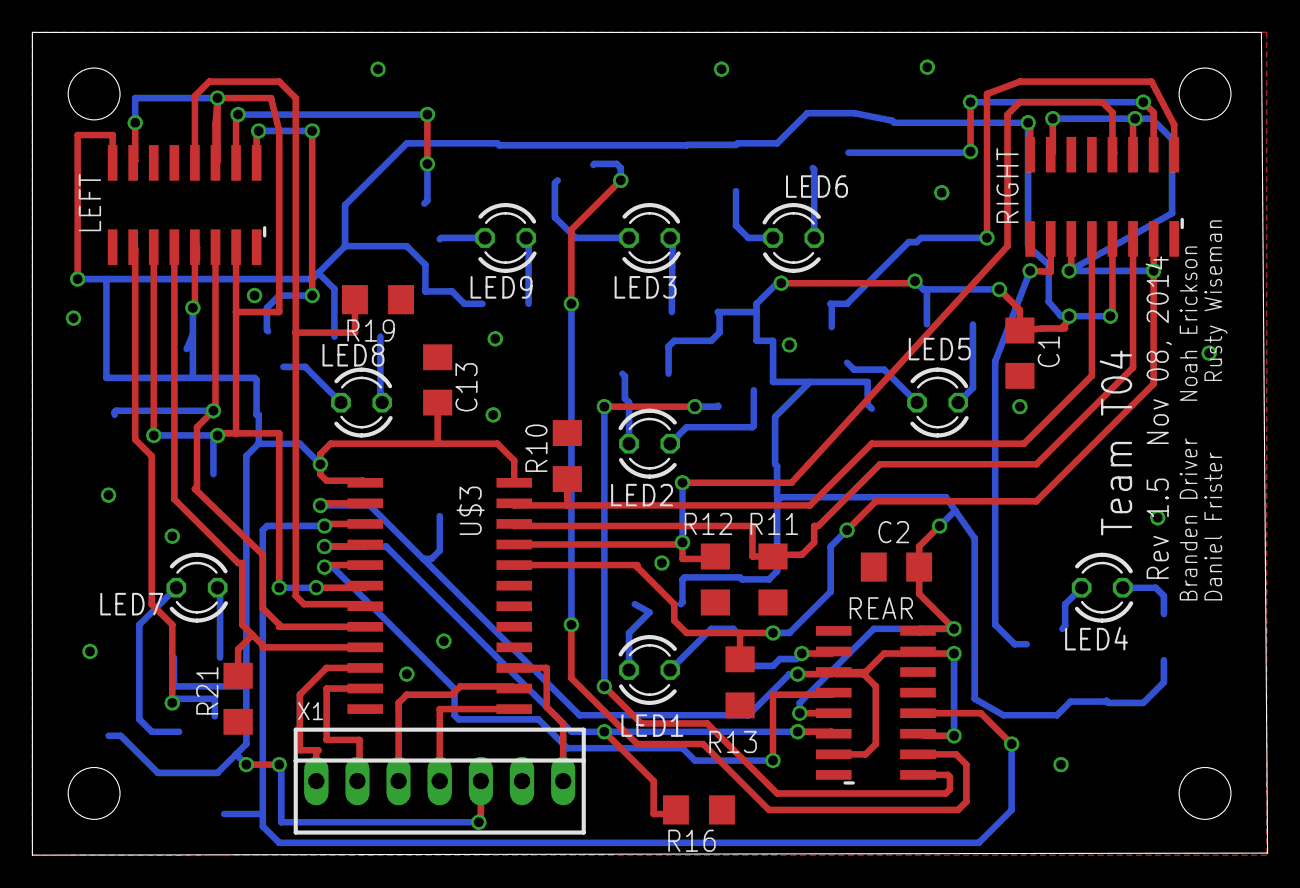
[picture p27: board T04_Display.brd from above]

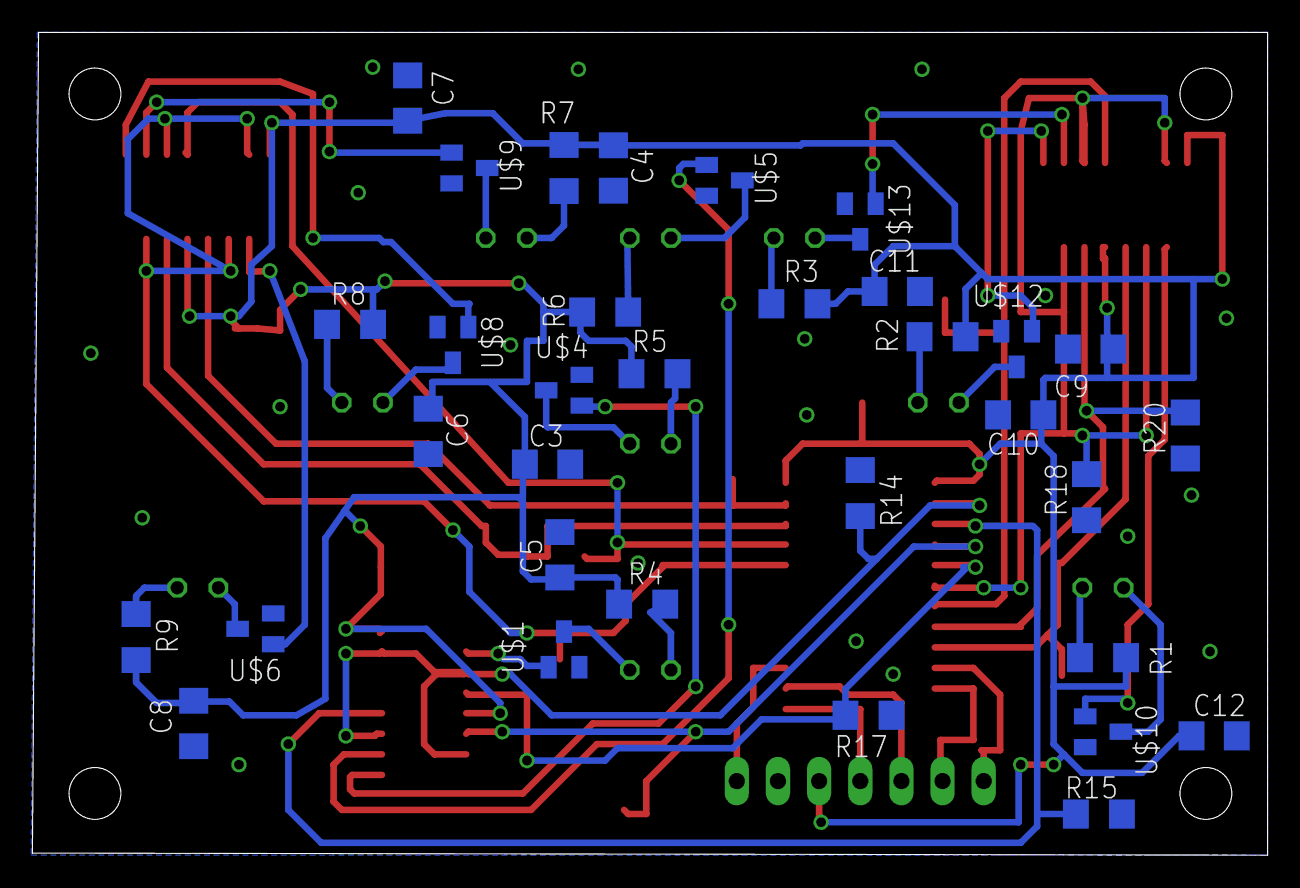
[picture p28: board T04_Display.brd from below]

Board: 2 copper layers, 76.3 x 50.8 mm, 57 parts (33 on the bottom side), 46 nets.
