dfrister/Practicum2014/Schematic and Layout/mainboard/T04_Main_Board.brd

## EAGLE design Schematic and Layout/mainboard/T04_Main_Board.brd (2014-11-10)

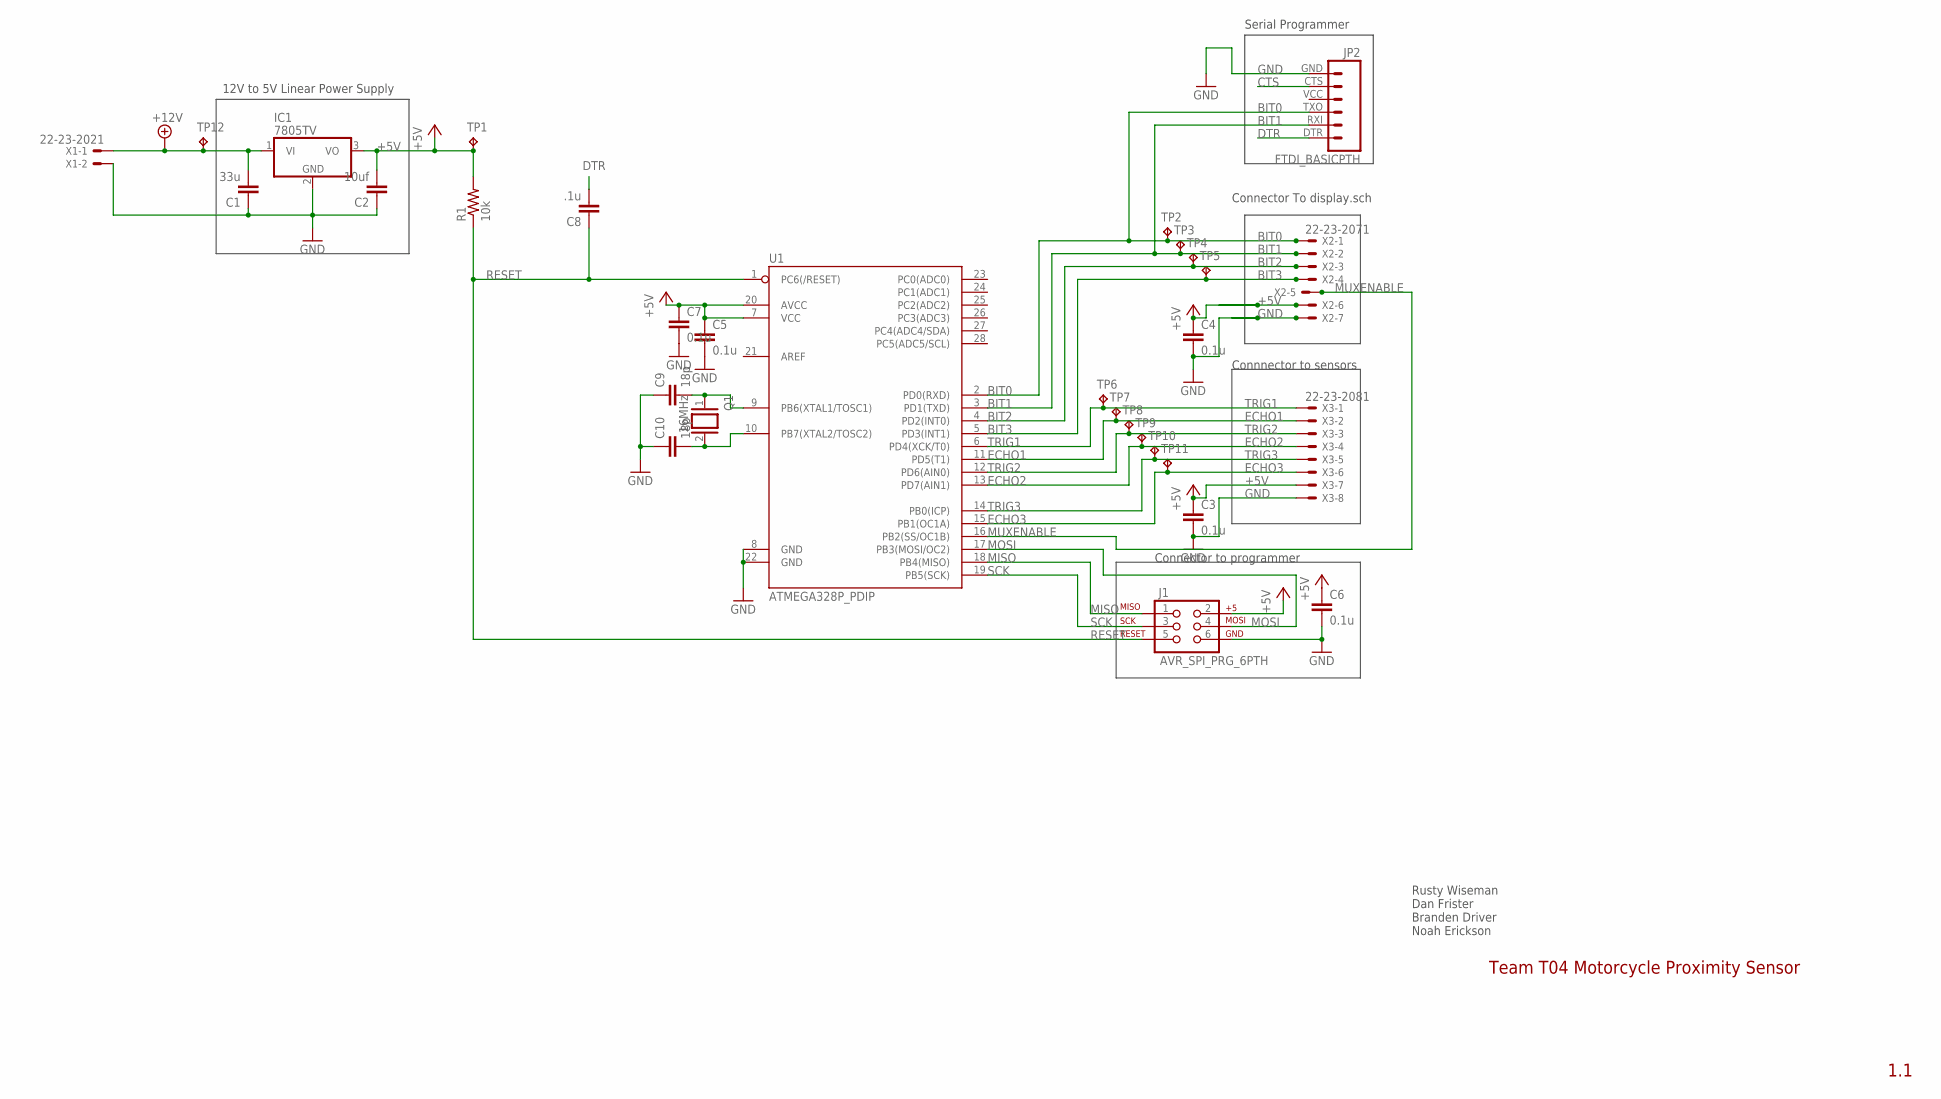
[picture p29: schematic T04_Main_Board.sch]

Parts:
C1: 33u; C1206
C2: 10uf; C1206
C3, C4, C5, C6, C7: 0.1u; C1206
C8: .1u; C1206
C9, C10: 18p; C1206
IC1: 7805TV; TO220V
J1: AVR_SPI_PRG_6PTH; 2X3
JP2: FTDI_BASICPTH; FTDI_BASIC
Q1: 16MHz; QS
R1: 10k; R1206
TP1, TP2, TP3, TP4, TP5, TP6, TP7, TP8, TP9, TP10, TP11, TP12: TPB1,27; B1,27
U1: ATMEGA328P_PDIP; DIL28-3
X1: 22-23-2021
X2: 22-23-2071
X3: 22-23-2081

Connections:
+5V: C2.2, C3.1, C4.1, C5.1, C6.1, C7.1, IC1.3 (VO), J1.2, R1.2, TP1.TP, U1.7 (VCC), U1.20 (AVCC), X2.6, X3.7
+12V: C1.2, IC1.1 (VI), TP12.TP, X1.1
BIT0: JP2.TXO (3), TP2.TP, U1.2 (PD0(RXD)), X2.1
BIT1: JP2.RXI (2), TP3.TP, U1.3 (PD1(TXD)), X2.2
BIT2: TP4.TP, U1.4 (PD2(INT0)), X2.3
BIT3: TP5.TP, U1.5 (PD3(INT1)), X2.4
CTS: JP2.CTS (5)
DTR: C8.2, JP2.DTR (1)
ECHO1: TP7.TP, U1.11 (PD5(T1)), X3.2
ECHO2: TP9.TP, U1.13 (PD7(AIN1)), X3.4
ECHO3: TP11.TP, U1.15 (PB1(OC1A)), X3.6
GND: C1.1, C2.1, C3.2, C4.2, C5.2, C6.2, C7.2, C9.1, C10.1, IC1.2 (GND), J1.6, JP2.GND (6), U1.8 (GND), U1.22 (GND), X1.2, X2.7, X3.8
MISO: J1.1, U1.18 (PB4(MISO))
MOSI: J1.4, U1.17 (PB3(MOSI/OC2))
MUXENABLE: U1.16 (PB2(SS/OC1B)), X2.5
unnamed: C10.2, Q1.2, U1.10 (PB7(XTAL2/TOSC2))
unnamed: C9.2, Q1.1, U1.9 (PB6(XTAL1/TOSC1))
RESET: C8.1, J1.5, R1.1, U1.1 (PC6(/RESET))
SCK: J1.3, U1.19 (PB5(SCK))
TRIG1: TP6.TP, U1.6 (PD4(XCK/T0)), X3.1
TRIG2: TP8.TP, U1.12 (PD6(AIN0)), X3.3
TRIG3: TP10.TP, U1.14 (PB0(ICP)), X3.5

Notes on the sheet:
12V to 5V Linear Power Supply
Connector To display.sch
Team T04 Motorcycle Proximity Sensor
1.1
Rusty Wiseman Dan Frister Branden Driver Noah Erickson
Connnector to sensors
Connector to programmer
Serial Programmer

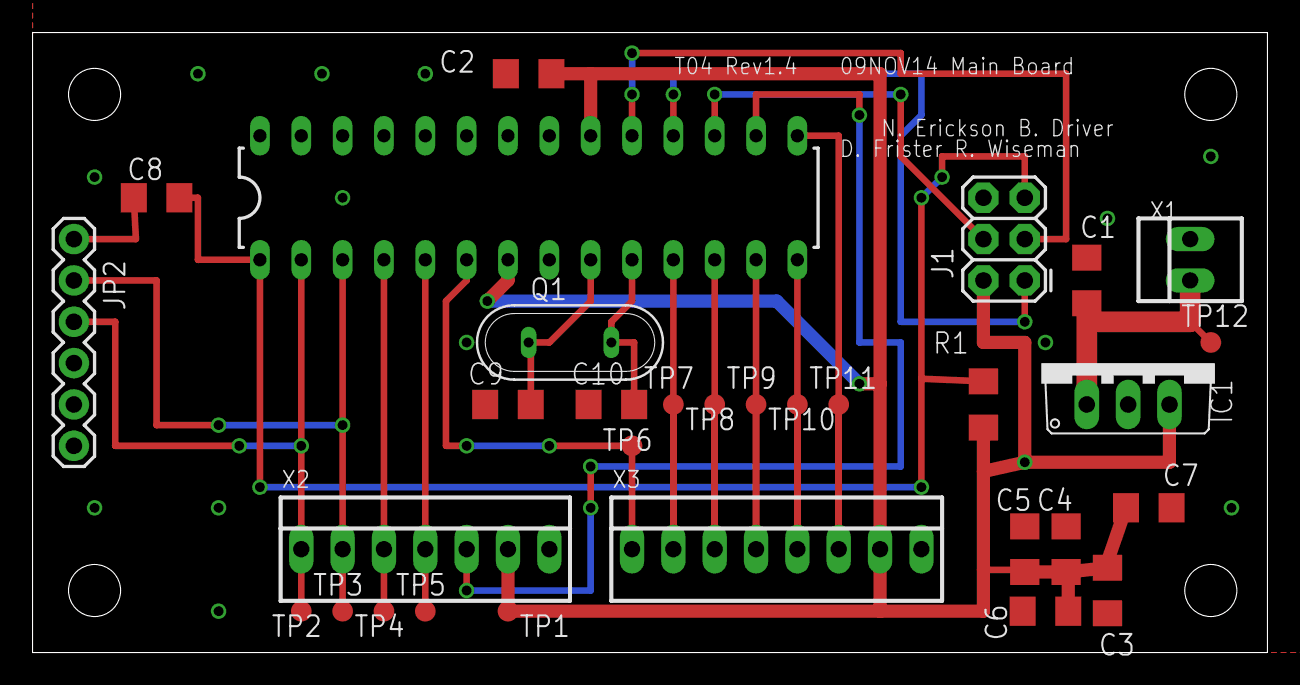
[picture p30: board T04_Main_Board.brd from above]

Board: 2 copper layers, 75.9 x 38.1 mm, 31 parts (0 on the bottom side), 21 nets.
