dfrister/Practicum2014/Schematic/proximity_sensor.sch

## EAGLE design Schematic/proximity_sensor.sch (2014-10-21)

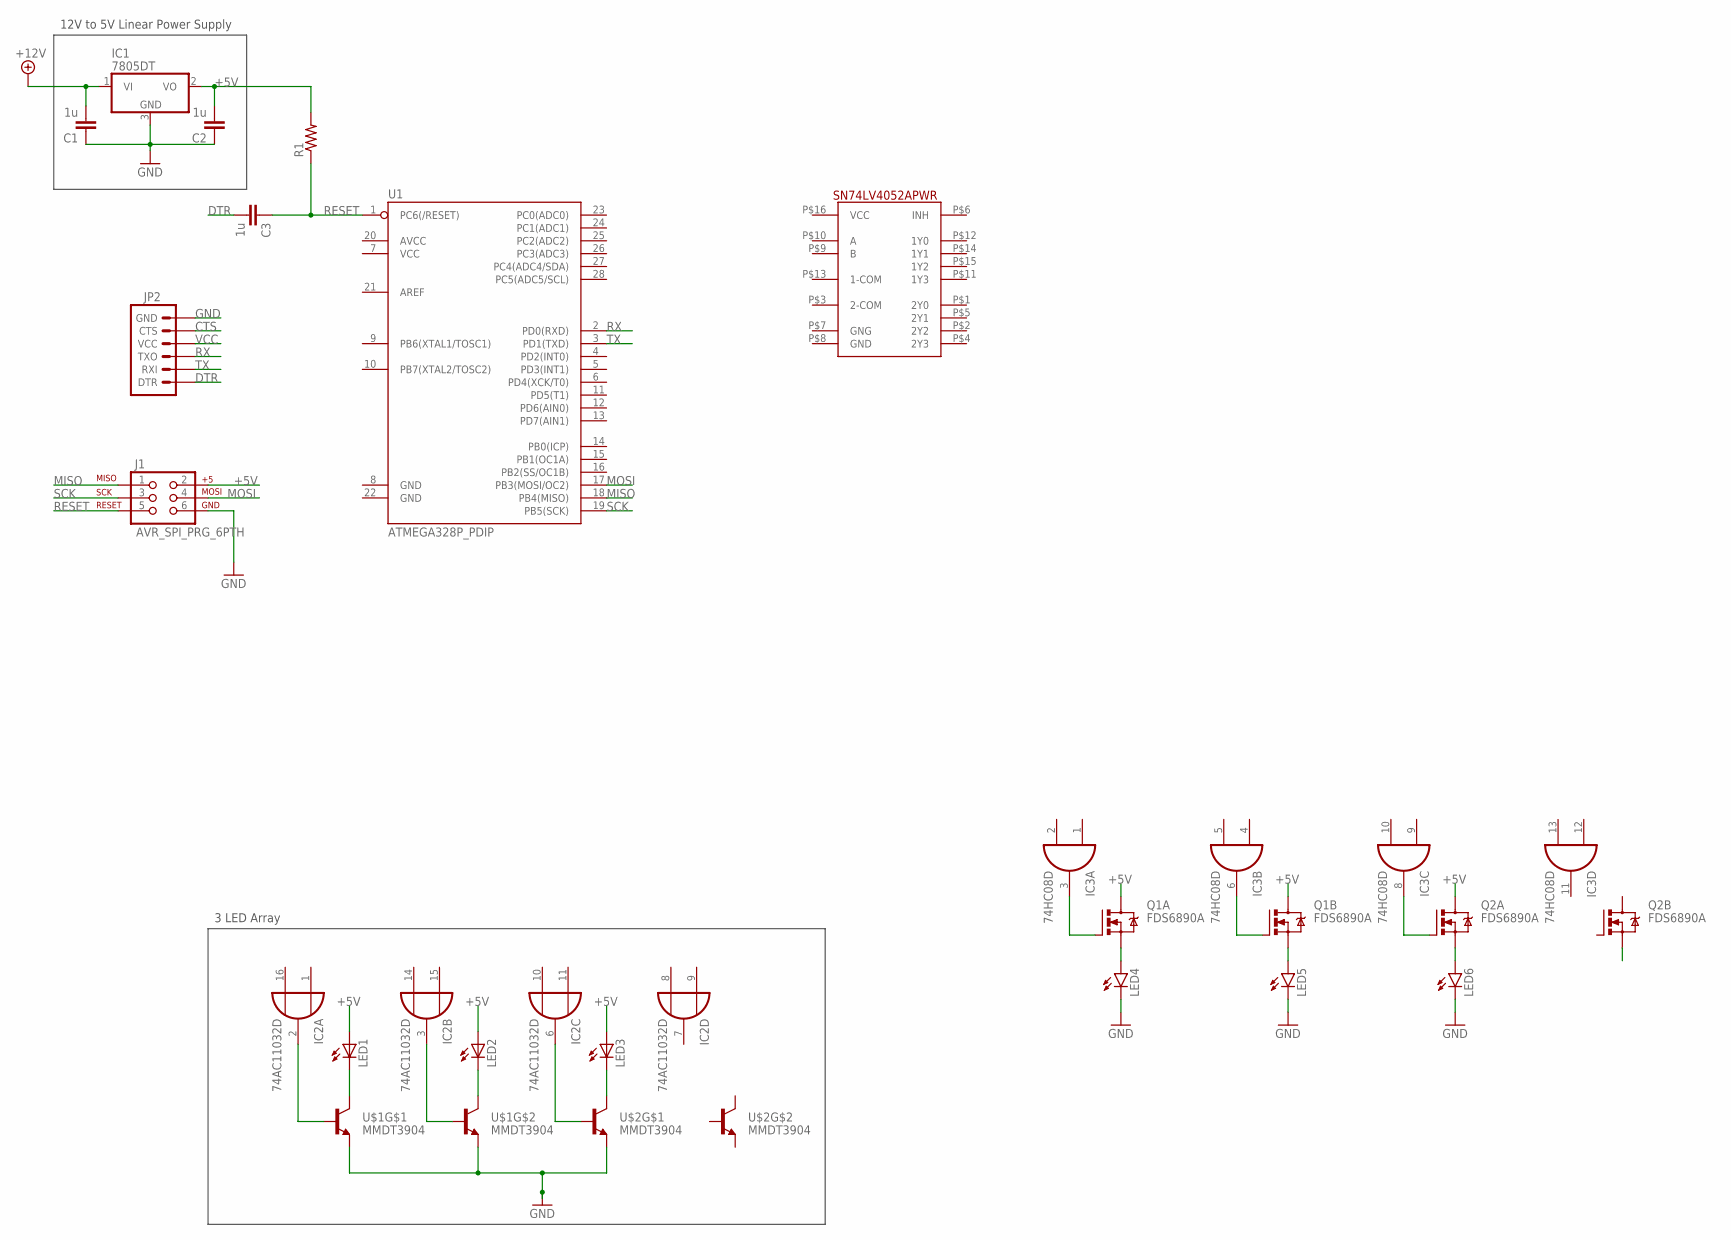
[picture p31: schematic proximity_sensor.sch]

Parts:
C1, C2, C3: 1u; C025-024X044
IC1: 7805DT; TO252
IC2: 74AC11032D; SO16
IC3: 74HC08D; SO14
J1: AVR_SPI_PRG_6PTH; 2X3
JP2: ARDUINO_SERIAL_PROGRAMPTH; 1X06
LED1, LED2, LED3: LED3MM
LED4, LED5, LED6: LED-3MM-NO_SILK; LED3MM-NS
Q1, Q2: FDS6890A; M08A
R1: R-US_0414/5V; 0414V
U1: ATMEGA328P_PDIP; DIL28-3
U$1, U$2: MMDT3904; SOT363
U$3: SV74LV4052APWR2; TVSOP-16

Connections:
+5V: C2.2, IC1.2 (VO), J1.2, LED1.A, LED2.A, LED3.A, Q1.5 (D), Q1.7 (D), Q2.7 (D), R1.2
+12V: C1.2, IC1.1 (VI)
CTS: JP2.CTS
DTR: C3.2, JP2.DTR
GND: C1.1, C2.1, IC1.3 (GND), J1.6, JP2.GND, LED4.K (C), LED5.K (C), LED6.K (C), U$1.1 (E), U$1.4 (E), U$2.1 (E)
MISO: J1.1, U1.18 (PB4(MISO))
MOSI: J1.4, U1.17 (PB3(MOSI/OC2))
unnamed: IC2.2 (O), U$1.2 (B)
unnamed: IC2.3 (O), U$1.5 (B)
unnamed: IC2.6 (O), U$2.2 (B)
unnamed: LED5.A, Q1.3 (S)
unnamed: LED1.K (C), U$1.6 (C)
unnamed: LED4.A, Q1.1 (S)
unnamed: LED6.A, Q2.1 (S)
unnamed: LED2.K (C), U$1.3 (C)
unnamed: LED3.K (C), U$2.6 (C)
unnamed: IC3.3 (O), Q1.2 (G)
unnamed: IC3.6 (O), Q1.4 (G)
unnamed: IC3.8 (O), Q2.2 (G)
RESET: C3.1, J1.5, R1.1, U1.1 (PC6(/RESET))
RX: JP2.TXO, U1.2 (PD0(RXD))
SCK: J1.3, U1.19 (PB5(SCK))
TX: JP2.RXI, U1.3 (PD1(TXD))
VCC: JP2.VCC

Notes on the sheet:
12V to 5V Linear Power Supply
3 LED Array
