dfrister/Practicum2014/Schematic/mainboard/mainboard.sch

## EAGLE design Schematic/mainboard/mainboard.sch (2014-10-28)

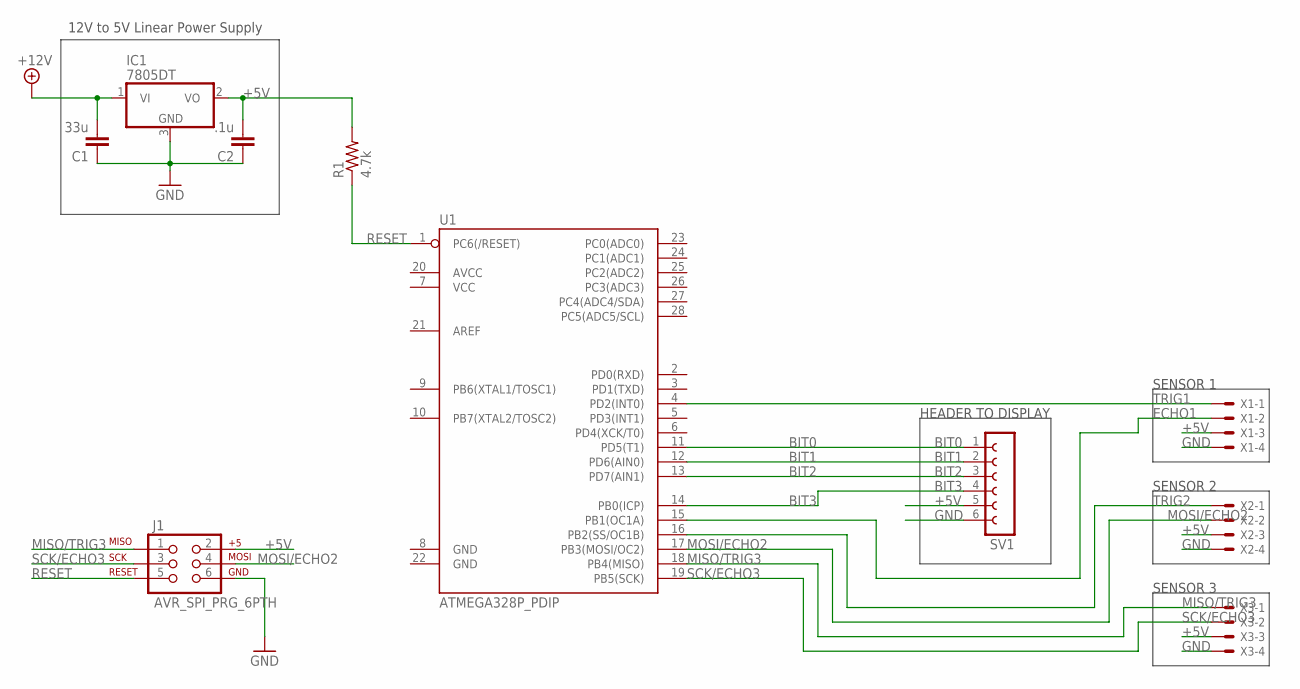
[picture p32: schematic mainboard.sch]

Parts:
C1: 33u; C025-024X044
C2: .1u; C025-024X044
IC1: 7805DT; TO252
J1: AVR_SPI_PRG_6PTH; 2X3
R1: 4.7k; 0414V
SV1: FE06-1; FE06
U1: ATMEGA328P_PDIP; DIL28-3
X1, X2, X3: KK-156-4

Connections:
+5V: C2.2, IC1.2 (VO), J1.2, R1.2, SV1.5, X1.3, X2.3, X3.3
+12V: C1.2, IC1.1 (VI)
BIT0: SV1.1, U1.11 (PD5(T1))
BIT1: SV1.2, U1.12 (PD6(AIN0))
BIT2: SV1.3, U1.13 (PD7(AIN1))
BIT3: SV1.4, U1.14 (PB0(ICP))
ECHO1: U1.15 (PB1(OC1A)), X1.2
GND: C1.1, C2.1, IC1.3 (GND), J1.6, SV1.6, X1.4, X2.4, X3.4
MISO/TRIG3: J1.1, U1.18 (PB4(MISO)), X3.1
MOSI/ECHO2: J1.4, U1.17 (PB3(MOSI/OC2)), X2.2
RESET: J1.5, R1.1, U1.1 (PC6(/RESET))
SCK/ECHO3: J1.3, U1.19 (PB5(SCK)), X3.2
TRIG1: U1.4 (PD2(INT0)), X1.1
TRIG2: U1.16 (PB2(SS/OC1B)), X2.1

Notes on the sheet:
12V to 5V Linear Power Supply
HEADER TO DISPLAY
SENSOR 1
SENSOR 2
SENSOR 3
