dfrister/Practicum2014/(commit log)

2014-10-12 Project files for 13OCT14 assignment. Decision Matrix based on coursework text appendix B and examples on page 22. Subjective weighting values for decisions based on discussions of each project durin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
    [Decision Matrix.xlsx]
2014-10-13 Added matrix description to matrix doc and added header and names to others. Ready to print and turn in.
2014-10-16 Initial Schematic
    [proximity_sensor.sch]
2014-10-20 Schematic Update
    [proximity_sensor.sch]
2014-10-21 Schematic update and meeting notes
    [proximity_sensor.sch]
2014-10-22 Breadboard Prototype
    [display.sch, mainboard.sch]
2014-10-22 Working Prototype
    [UnoBuild.fzz]
2014-10-24 Added component spreadsheet and datasheets for leds, fets, and demux
2014-10-24 Basic layout of display circuit. Componant values and part numbers require update. Still needs interface to main board.
    [display.sch]
2014-10-25 Mainboard schematic
2014-10-25 Finished draft of Requirements Specifications.
    [Components and Pricing Sheet.xlsx, Requirements Specs HW.xlsx]
2014-10-26 Prototype Code Update
2014-10-26 New datasheets and updated components spreadsheet with new components and prototype parts order.
    [Components and Pricing Sheet.xlsx]
2014-10-26 Prototype 2 w/ 2 Sensors
2014-10-26 Prototype rev3 with 2 sensors
    [UnoBuild.fzz]
2014-10-26 Prototype rev3 with 2 sensors (fixed)
2014-10-28 Prototype_rev4 added, schematic update. Also fixed old prototypes being overwritten, oops.
    [mainboard.sch]
2014-10-28 prototype_rev4 (fix)
2014-10-29 Finalized V1.0 Schematics for assignment.
    [display.sch]
2014-10-29 ERC Update Display Schematic
    [T04_Display.sch]
2014-10-30 Mainboard Update and Prototype_rev4 update
    [T04_Main_Board.sch]
2014-10-31 Board Layout Rev1
    [T04_Main_Board.brd]
2014-10-31 V1.1 Schematic, with latches
    [T04_Display.sch]
2014-11-01 Preliminary Board Layout Rev.1
    [T04_Display.sch]
2014-11-01 Deleted # files
    [T04_Display.brd, T04_Display_Branden.brd, T04_Display_Branden.sch]
2014-11-01 Udpated layout with team names on board and more clearly labeled component names
    [T04_Display.brd]
2014-11-04 Mainboard update - Clock and bypass caps
    [T04_Main_Board.brd, T04_Main_Board.sch]
2014-11-04 Mainboard - Added mounting holes
    [T04_Main_Board.brd]
2014-11-05 Fixed DRC errors on C3.
    [T04_Main_Board.brd]
2014-11-05 Mainboard layout fixed
    [T04_Main_Board.brd, T04_Main_Board.sch]
2014-11-05 Reverified ERC/DRC for assignment files, added version summery.
    [T04_Display.brd, T04_Display.sch, T04_Main_Board.brd, T04_Main_Board.sch]
2014-11-06 Delete 2n7002dw dual fet.pdf
    Trimming datasheets not being used.
2014-11-07 Mainboard & Display layout updates - Molex connectors, Mounting Holes, Greenberg Email Additions
    [T04_Display.brd, T04_Display.sch, T04_Main_Board.brd, T04_Main_Board.sch]
2014-11-08 Updated Schematic and Revision text to match instructor review.
    [T04_Display.brd, T04_Display.sch]
2014-11-09 Updated display board
    [T04_Display.brd]
2014-11-09 Second layout option for display using enable pins and smaller area.
    [T04_Display.brd, T04_Display.sch, T04_Main_Board.brd, T04_Main_Board.sch]
2014-11-09 M@INb0@RD C0MPl37e
    [T04_Main_Board.brd, T04_Main_Board.sch]
2014-11-09 3V3RY7H1NG 15 C0MPl373
    [T04_Main_Board.brd, T04_Main_Board.sch]
2014-11-09 Rev 1.5 of display board. Still needs updated mulex connector
    [T04_Display.brd]
2014-11-09 Fixed drc error from previous committ
    [T04_Display.brd]
2014-11-09 Display w/ 7-pin molex
    [T04_Display.brd, T04_Display.sch]
2014-11-09 Mainboard Rev 1.3 Update
    [T04_Main_Board.brd]
2014-11-09 Rev 1.4 Schematics/Layouts
    [T04_Display.brd, T04_Main_Board.brd, T04_Main_Board.sch]
2014-11-09 Final Schematic - Mainboard
    [T04_Main_Board.brd, T04_Main_Board.sch]
2014-11-09 Final Revision for display before submit.
    [T04_Display.brd, T04_Display.sch]
2014-11-10 File Cleanup
    [T04_Display.brd, T04_Display.sch, T04_Main_Board.brd, T04_Main_Board.sch]
2014-11-10 Submitted Files to OSHpark, updated versions.
    [T04_Display.brd, T04_Display.sch, T04_Main_Board.brd, T04_Main_Board.sch]
2014-11-10 Branden's display design
    [T04_Display.brd, T04_Display.sch]
2014-11-18 Uploaded sensor enclosure drawings, pdf and svg.
2014-11-21 Updated drawing for three enclosures
2014-11-22 Updated version of sensor enclosure. DON'T USE YET!!
2014-11-23 Test case for demux
    [Test_Case_4.4.1_demux.xlsx]
2014-11-23 Completed review of complete test plan, added power test for display. Added test plan for integration 1. Moved Hello World test plan to xlsx format properly. Updated revision numbers.
    [TestCaseMainboardHelloWorld.xls, Test_Case_4.2.1_helloworld.xlsx, Test_Case_4.4.2_demux.xlsx, Test_Case_4.5.1_integration.xlsx]
2014-11-23 File cleanup.
    [Test_Case_4.4.1_demux.xlsx, Test_Case_4.4.2_demux.xlsx]
2014-11-23 Brandon's Display Enclosure Rev1.0/Bottom_Piece.pdf(Rev1) and my Display Enclosure (Rev2)
2014-11-24 System Test Plan added
    [Test_Case_4.5.3_system.xlsx]
2014-11-24 Finalized versions of test plans (formatted) and complete assignment pdf.
    [Test_Case_4.2.1_helloworld.xlsx, Test_Case_4.5.1_integration.xlsx, Test_Case_4.5.3_system.xlsx]
2014-11-24 Fixed display board version numbers.
2014-11-29 revised display rev2 to pieces for three enclosures.
2014-12-05 Code header matches schematic header
2014-12-06 LED iteration code
2014-12-08 Updated enclosures. Use Mainboard Enclosure_V2.svg.
2014-12-10 Updated Prototype code for long range Began powerpoint
2014-12-11 Code organization
    [UnoBuild.fzz]
2014-12-12 this is actually Noah fixing the powerpoint!
